eSpark-Backup/manar-harake-s-e-m-g-device/Deliverables/ArmBand-Electrode-Board/_Renderings/3D_Bottom_View.PNG

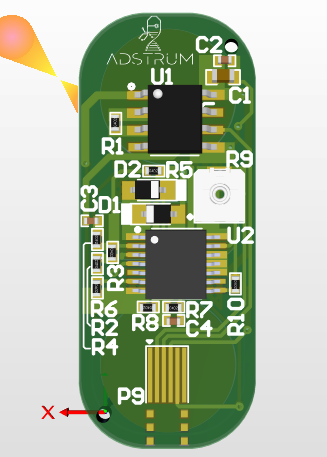
Deliverables/ArmBand-Electrode-Board/_Renderings/3D_Bottom_View.PNG
