eSpark-Backup/manar-harake-s-e-m-g-device/Documents/Client Shared/data acquisition- Flow diagram.pdf

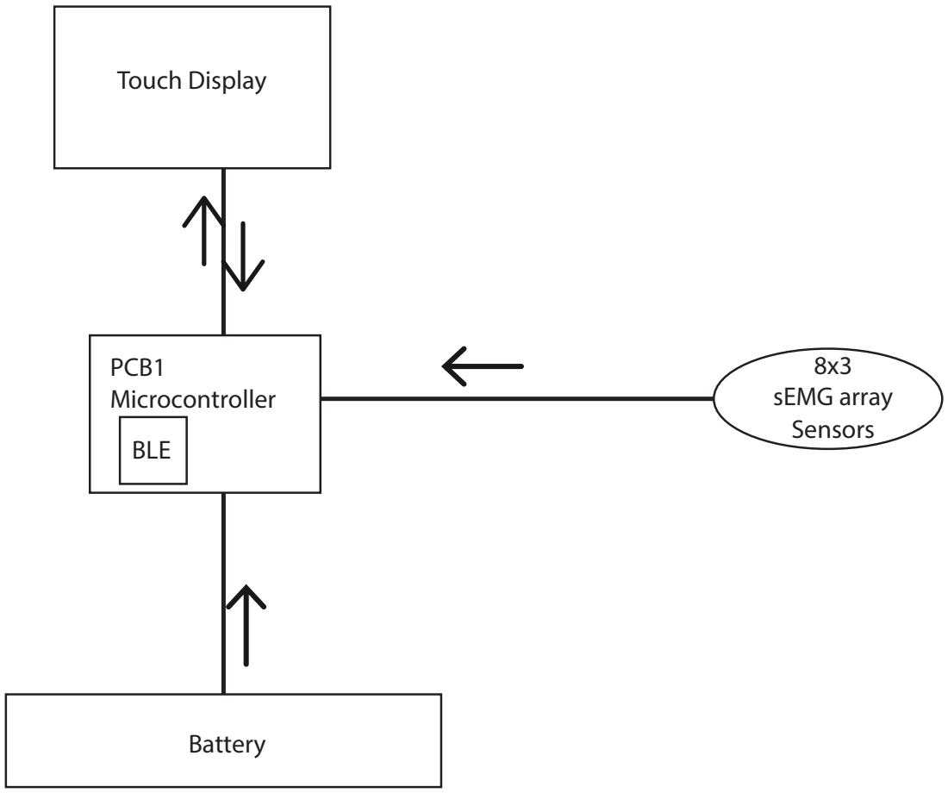
[picture p3: figure]
Touch Display; PCB1 Microcontroller; BLE; 8x3 sEMG array Sensors; Battery
