eSpark-Backup/manar-harake-s-e-m-g-device/Deliverables/ArmBand-Control-Board/_Renderings/2D_Top_View.PNG

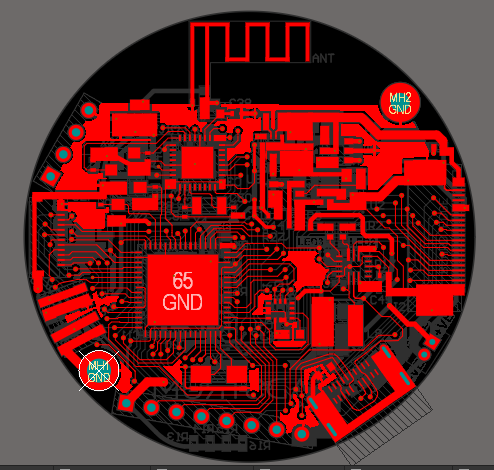
Deliverables/ArmBand-Control-Board/_Renderings/2D_Top_View.PNG
