eSpark-Backup/manar-harake-s-e-m-g-device/Deliverables/ArmBand-Electrode-Board/_Renderings/2D_Top_View.PNG

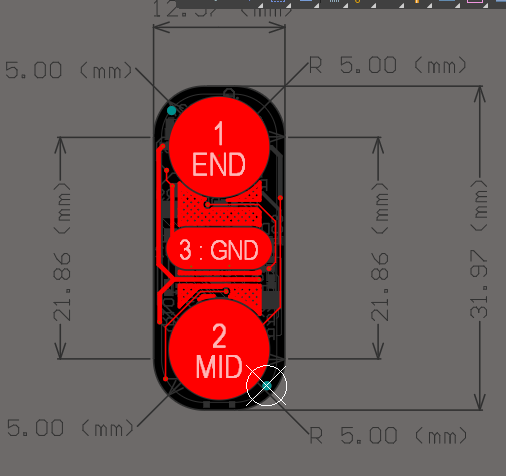
Deliverables/ArmBand-Electrode-Board/_Renderings/2D_Top_View.PNG
