eSpark-Backup/manar-harake-s-e-m-g-device/Deliverables/ArmBand-Electrode-Board/_Renderings/Isometric_View.PNG

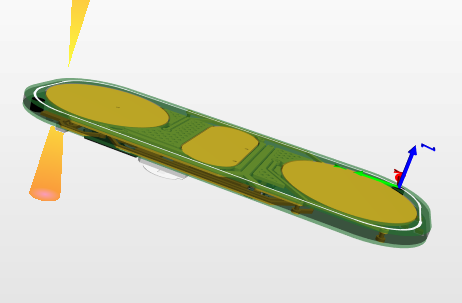
Deliverables/ArmBand-Electrode-Board/_Renderings/Isometric_View.PNG
