eSpark-Backup/manar-harake-s-e-m-g-device/Deliverables/ArmBand-Sensor-Board/_Renderings/2D_Bottom_View.PNG

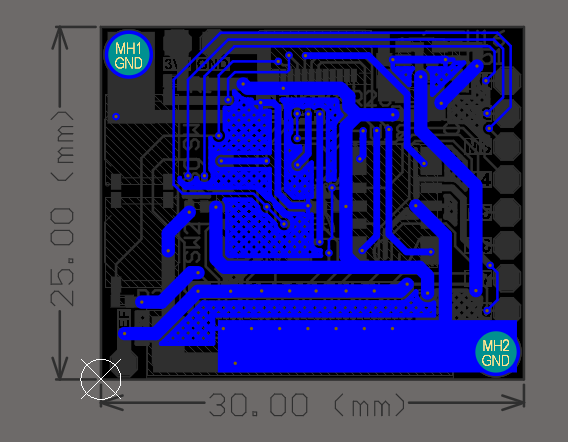
Deliverables/ArmBand-Sensor-Board/_Renderings/2D_Bottom_View.PNG
