eSpark-Backup/manar-harake-s-e-m-g-device/Deliverables/ArmBand-Sensor-Board/_Renderings/2D_C_View.PNG

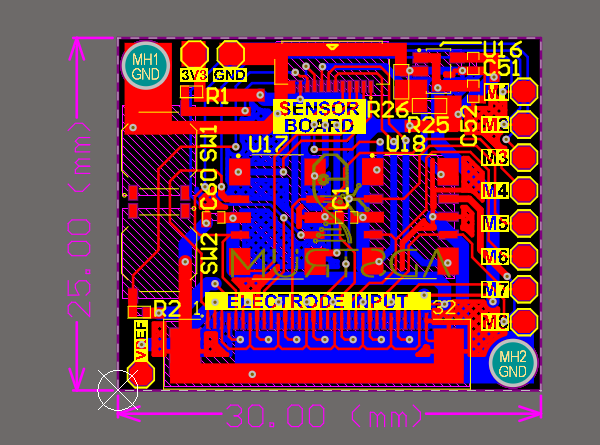
Deliverables/ArmBand-Sensor-Board/_Renderings/2D_C_View.PNG
