eSpark-Backup/manar-harake-s-e-m-g-device/Deliverables/ArmBand-Sensor-Board/_Renderings/3D_Top_View.PNG

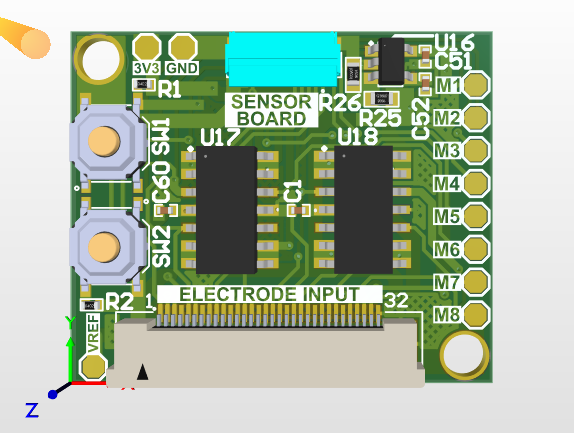
Deliverables/ArmBand-Sensor-Board/_Renderings/3D_Top_View.PNG
