eSpark-Backup/manar-harake-s-e-m-g-device/Deliverables/Control-Board-Flexible-PCB/_Renderings/3D_Top_View.PNG

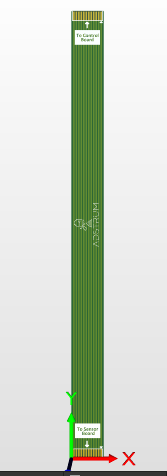
Deliverables/Control-Board-Flexible-PCB/_Renderings/3D_Top_View.PNG
