eSpark-Backup/manar-harake-s-e-m-g-device/Deliverables/Control-Board-Flexible-PCB/_Renderings/Isometric_View.PNG

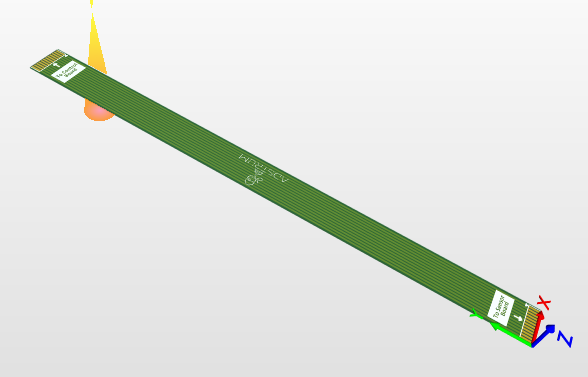
Deliverables/Control-Board-Flexible-PCB/_Renderings/Isometric_View.PNG
