eSpark-Backup/manar-harake-s-e-m-g-device/Deliverables/BOM/Control-Board/Client_BOM-Control-Board.xlsx

 | Component list |  | Bill of Materials for Project [ArmBand-Control-Board.PrjPcb] (No PCB Document Selected)
 | Source Data From: |  | ArmBand-Control-Board.PrjPcb
 | Project: |  | ArmBand-Control-Board.PrjPcb
 | Variant: |  | None
# | Designator | Description | Footprint | Manufacturer Part Number | Manufacturer | Comment | Quantity (1 Board) | Quantity 5 Boards | Remarks
1 | C1, C2, C7 | 0805 22 uF 25 V ±20% Tolerance X5R SMT Multilayer Ceramic Capacitor, CAP CER 22UF 25V X5R 0805 | Cap0805 | GRM21BR61E226ME44L | Murata | 22uF | 3 | 15
2 | C3, C4, C6, C10, C11, C12, C13, C14, C15, C18, C19, C20, C21, C22, C23, C24, C31, C34, C35, C36, C41, C42, C47, C49 | CAP CER 0.1UF 50V X7R 0402 | Cap 0402 | GRM155R71H104ME14D | Murata | 0.1uF | 24 | 120
3 | C5 | CAP CER 10UF 25V X5R 0603 | Cap0603 | CL10A106MA8NRNC | Samsung | 10uF | 1 | 5
4 | C8, C25, C26, C27, C28, C39, C40, C50 | CAP CER 20PF 50V C0G/NPO 0402 | Cap 0402 | CC0402JRNPO9BN200 | Yageo | 20pF | 8 | 40
5 | C9, C33 | 16V 4.7uF ±20% 0402 Multilayer Ceramic Capacitors MLCC | Cap 0402 | EDK105BBJ475MVLF | Taiyo Yuden | 4.7uF | 2 | 10
6 | C16, C32, C43, C45, C46, C48, C51 | CAP CER 1UF 16V X5R 0402 | Cap 0402 | CC0402KRX5R7BB105 | Yageo | 1uF | 7 | 35
7 | C17 | CAP CER 2.2UF 25V X5R 0402 | Cap 0402 | GRM155R61E225KE11D | Murata | 2.2uF | 1 | 5
8 | C37 | CAP CER 100pF 50V C0G 0402 | Cap 0403 | GCM1555C1H101JA16D | Murata | 100pF | 1 | 5
9 | C44 | CAP CER 1000PF 25V X7R 0402 | Cap 0402 | CC0402KRX7R8BB102 | Yageo | 1nF | 1 | 5
10 | C38 | CAP CER 0.8PF 50V C0G/NP0 0402 | Cap 0402 | GJM1555C1HR80WB01D | Murata | 0.8pF | 1 | 5
11 | J1 | CONN U.FL RCPT STR 50 OHM SMD | Custom | U.FL-R-SMT-1(80) | Hirose | --------- | 1 | 5
12 | J4 | CONN RCP USB3.1 TYPEC 24P SMD RA | Custom | 2305018-2 | TE Connectivity AMP | --------- | 1 | 5
13 | J3 | CONN HEADER VERT 2POS 1.5MM | Custom | B2B-ZR(LF)(SN) | JST | --------- | 1 | 5
14 | J2 | Clamshell 22 Double-sided contacts/up and down connection Surface Mount 0.5mm SMD,P=0.5mm FFC/FPC Connectors ROHS | Custom | F0504-H-22-20T-R | XFCN | --------- | 1 | 5
15 | J5 | CONN HEADER VERT 8POS 2.54MM | SMD Header 1x8 | 61300811121 | Wurth Electronics | --------- | 1 | 5
16 | J6 | CONN FPC/FFC 12POS .5MM | Custom | FH34SRJ-12S-0.5SH(50) | Hirose | --------- | 1 | 5
17 | J7 | CONN HEADER VERT 4POS 2.54MM | HDR1X4 SMD | 61300411121 | Wurth Electronics | --------- | 1 | 5
18 | L1 | FIXED IND 2.2UH 1.5A 160MOHM SMD | Custom | MAKK2016T2R2M | Taiyo Yuden | 2.2uH | 1 | 5
19 | L3 | 500mA 10uH ±20% 320mΩ 0805 Inductors (SMD) ROHS | Ind0805 | MGFL2012F100MT-LF | microgate | 10uH | 1 | 5
20 | L4 | 550mA 15nH ±5% 150mΩ SMD,1.68x1x0.85mm Inductors (SMD) ROHS | Custom | SCW1608C15NJST | Sunltech | 15nH | 1 | 5
21 | L5 | Inductor RF Chip Wirewound 3.9nH 0.2nH 100MHz 38Q-Factor 1A 32mOhm DCR 0603 Paper T/R | IND 0603 | LQW18AN3N9C10D | Murata | 3.9nH | 1 | 5
22 | L6 | FERRITE BEAD 30 OHM 0603 1LN / Ferrite Beads Multi-Layer 30Ohm 100MHz 1A 0.05Ohm DCR 0603 T/R | IND 0603 | BLM18PG300SN1D | Murata | ---------- | 1 | 5
23 | L8 | 2.7A 6.8uH ±20% 50mΩ SMD Power Inductors ROHS | Custom | LVC505040-6R8M-N | Chlisin Elec | 6.8uH | 1 | 5
24 | LED1, LED3 | LED GREEN CLEAR CHIP SMD | LED 0402 | XZVG68W-2 | SunLED | ---------- | 2 | 10
25 | LED2 | LED RED CLEAR CHIP SMD | LED 0402 | XZMDK68W-2 | SunLED | ---------- | 1 | 5
26 | R1 | RES SMD 25m Ohms 125mW 0805 | Res0805 | 0805W8F250MT5E | UNI-ROYAL | 0.25R | 1 | 5
27 | R2, R3, R9, R28 | RES 1K OHM 5% 1/16W 0402 | Res0402 | RC0402JR-071KL | Yageo | 1K | 4 | 20
28 | R4, R5, R6, R12, R18, R19, R22, R23, R25, R27 | RES SMD 10K OHM 1% 1/16W 0402 | Res0402 | RC0402FR-0710KL | Yageo | 10K | 10 | 50
29 | R7, R8, R13, R14, R15, R16, R17, R26 | RES SMD 100K OHM 1% 1/5W 0402 | Res0402 | ERJ-PA2F1003X | Panasonic | 100K | 8 | 40
30 | R10, R11 | RES SMD 4.7K OHM 5% 1/10W 0402 | Res0402 | ERJ-2GEJ472X | Panasonic | 4.7K | 2 | 10
31 | R20, R21 | RES 5.1K OHM 1% 1/10W 0603 | Res0603 | RMCF0603FT5K10 | Stackpole Electronics | 5.1K | 2 | 10
32 | R24 | RES SMD 0402 10.7kOhm 0.5% Paper T/R | Res0402 | AC0402DR-0710K7L | Yageo | 10.7K | 1 | 5
33 | ~~SB1, SB2, SB3~~ | ~~Solder Bridge ON~~ | ~~Solder Bridge~~ | ~~----------~~ | ~~----------~~ | ~~----------~~ | ~~3~~ | ~~15~~ | ~~DO NOT MOUNT~~
34 | SW1, SW2 | 3mm 2mm Round Button 50mA Top3.65mm SPST 12V SMD Tactile Switches | Custom | TS-1185EC-C-D-B | XKB | ---------- | 2 | 10
35 | U1 | 2.1A, 1- OR 2-CELL LI-ION BATTER | QFN(3X3) | MP2615CGQ-Z | Monolithic Power Systems | ---------- | 1 | 5
36 | U2 | IC MPU/RESET CIRC SOT23-3 | SOT-23 | MAX809SEUR+T | Maxim | ---------- | 1 | 5
37 | U3 | IC PWR SWITCH P-CH 1:1 SUPERSOT6 | SuperSOT™-6 | FDC6330L | ON Semiconductor / Fairchild | ---------- | 1 | 5
38 | U4 | Buck Switching Regulator IC Positive Fixed 3.3V 1 Output 1A 8-WFDFN Exposed Pad | 8-WSON (2x2) | TPS62162DSGR | Texas Instruments | ---------- | 1 | 5
39 | U5 | IC MCU 32BIT 512KB FLASH 64QFN | QFN64 | ATSAM4S8BA-MU | Microchip | ---------- | 1 | 5
40 | U6 | IC RF TXRX+MCU BLUETOOTH 32WFQFN | 32 QFN | NRF52810-QCAA-R | Nordic Semiconductor | ---------- | 1 | 5
41 | U7 | iNEMO Inertial Module: 3D Accelerometer and 3D Gyroscope, 1.71V to 3.6V, -40°C to 85°C, VFLGA-14L, RoHS | 14-LGA (2.5x3) | LSM6DSRTR | STMicroelectronics | ---------- | 1 | 5
42 | U8 | 300mA 75dB@1kHz 10nA 90mV 2.8V~2.8V 2 6V SOT-23-6 Linear Voltage Regulators (LDO) ROHS | SOT-23-6 | VRD2828PTX | AnaSem | ---------- | 1 | 5
43 | X1, X4 | 32.768kHz SMD Crystal Resonator 12.5pF ±20ppm -40℃~+85℃ SMD3215-2P Crystals ROHS | Custom | X321532768KGD2SI | Yangxing Tech | 32.768kHz | 2 | 10
44 | X2 | 16MHz SMD Crystal Resonator 12pF ±10ppm ±30ppm -40℃~+85℃ SMD3225-4P Crystals ROHS | Custom | X322516MOB4SI | Yangxing Tech | 16MHz | 1 | 5
45 | X3 | 32MHz SMD Crystal Resonator 12pF 40Ω ±10ppm ±20ppm -40℃~+85℃ SMD3225-4P Crystals ROHS | Custom | XC32M4-32.000-F12NLDT | HCI | 32MHz | 1 | 5
 | Approved
 | Notes
