eSpark-Backup/manar-harake-s-e-m-g-device/Deliverables/BOM/Control-Board/eSpark_BOM-Control-Board.xlsx

 | Component list |  | Bill of Materials for Project [ArmBand-Control-Board.PrjPcb] (No PCB Document Selected)
 | Source Data From: |  | ArmBand-Control-Board.PrjPcb
 | Project: |  | ArmBand-Control-Board.PrjPcb
 | Variant: |  | None
# | Designator | Description | Footprint | Manufacturer Part Number | Alternate Part No | Manufacturer | LCSC/Part No | Comment | Quantity (1 Board) | Quantity (5 Boards) | LCSC/MOQ/5 Boards | Links | Unit Cost/5 Boards | Total Cost/5 Boards | Remarks (Iftikhar) | Remarks (Faizan)
1 | C1, C2, C7 | 0805 22 uF 25 V ±20% Tolerance X5R SMT Multilayer Ceramic Capacitor, CAP CER 22UF 25V X5R 0805 | Cap0805 | GRM21BR61E226ME44L | --------- | Murata | C86816 | 22uF | 3 | 15 | 20 | LCSC (https://lcsc.com/product-detail/Multilayer-Ceramic-Capacitors-MLCC-SMD-SMT_Murata-Electronics-GRM21BR61E226ME44L_C86816.html) | $0.0694 | $1.3880
2 | C3, C4, C6, C10, C11, C12, C13, C14, C15, C18, C19, C20, C21, C22, C23, C24, C31, C34, C35, C36, C41, C42, C47, C49 | CAP CER 0.1UF 50V X7R 0402 | Cap 0402 | ~~GRM155R71H104ME14D~~ | CL05B104KB54PNC | Murata | C307331 | 0.1uF | 24 | 120 | 150 | LCSC (https://lcsc.com/product-detail/Multilayer-Ceramic-Capacitors-MLCC-SMD-SMT_Samsung-Electro-Mechanics-CL05B104KB54PNC_C307331.html) | $0.0072 | $1.0800
3 | C5 | CAP CER 10UF 25V X5R 0603 | Cap0603 | ~~CL10A106MA8NRNC~~ | GRM188R61E106MA73D | Samsung | C91606 | 10uF | 1 | 5 | 10 | LCSC (https://lcsc.com/product-detail/Multilayer-Ceramic-Capacitors-MLCC-SMD-SMT_Murata-Electronics-GRM188R61E106MA73D_C91606.html) | $0.0328 | $0.3280 |  | Part changed, orignal discontinued
4 | C8, C25, C26, C27, C28, C39, C40, C50 | CAP CER 20PF 50V C0G/NPO 0402 | Cap 0402 | CC0402JRNPO9BN200 | --------- | Yageo | C107000 | 20pF | 8 | 40 | 100 | LCSC (https://lcsc.com/product-detail/Multilayer-Ceramic-Capacitors-MLCC-SMD-SMT_YAGEO-CC0402JRNPO9BN200_C107000.html) | $0.0014 | $0.1400
5 | C9, C33 | 16V 4.7uF ±20% 0402 Multilayer Ceramic Capacitors MLCC | Cap 0402 | EDK105BBJ475MVLF | --------- | Taiyo Yuden | C412302 | 4.7uF | 2 | 10 | 50 | LCSC (https://lcsc.com/product-detail/Multilayer-Ceramic-Capacitors-MLCC-SMD-SMT_Taiyo-Yuden-EDK105BBJ475MVLF_C412302.html) | $0.0185 | $0.9250
6 | C16, C32, C43, C45, C46, C48, C51 | CAP CER 1UF 16V X5R 0402 | Cap 0402 | CC0402KRX5R7BB105 | --------- | Yageo | C325464 | 1uF | 7 | 35 | 50 | LCSC (https://lcsc.com/product-detail/Multilayer-Ceramic-Capacitors-MLCC-SMD-SMT_YAGEO-CC0402KRX5R7BB105_C325464.html) | $0.0065 | $0.3250
7 | C17 | CAP CER 2.2UF 25V X5R 0402 | Cap 0402 | GRM155R61E225KE11D | --------- | Murata | C385032 | 2.2uF | 1 | 5 | 10 | LCSC (https://lcsc.com/product-detail/Multilayer-Ceramic-Capacitors-MLCC-SMD-SMT_Murata-Electronics-GRM155R61E225KE11D_C385032.html) | $0.0489 | $0.4890
8 | C37 | CAP CER 100pF 50V C0G 0402 | Cap 0403 | GCM1555C1H101JA16D | --------- | 100pF | C126492 | 100pF | 1 | 5 | 50 | LCSC (https://lcsc.com/product-detail/Multilayer-Ceramic-Capacitors-MLCC-SMD-SMT_Murata-Electronics-GCM1555C1H101JA16D_C126492.html) | $0.0095 | $0.4800
9 | C44 | CAP CER 1000PF 25V X7R 0402 | Cap 0402 | CC0402KRX7R8BB102 | --------- | Yageo | C541372 | 1nF | 1 | 5 | 100 | LCSC (https://lcsc.com/product-detail/Multilayer-Ceramic-Capacitors-MLCC-SMD-SMT_YAGEO-CC0402KRX7R8BB102_C541372.html) | $0.0016 | $0.1600
10 | C38 | CAP CER 0.8PF 50V C0G/NP0 0402 | Cap 0402 | GJM1555C1HR80WB01D | --------- | Murata | C88902 | 0.8pF | 1 | 5 | 20 | LCSC (https://lcsc.com/product-detail/Multilayer-Ceramic-Capacitors-MLCC-SMD-SMT_Murata-Electronics-GJM1555C1HR80WB01D_C88902.html) | $0.0303 | $0.6060
11 | J1 | CONN U.FL RCPT STR 50 OHM SMD | Custom | U.FL-R-SMT-1(80) | --------- | Hirose | C88374 | --------- | 1 | 5 | 10 | LCSC (https://lcsc.com/product-detail/RF-Connectors-Coaxial-Connectors_HRS-Hirose-U-FL-R-SMT-1-80_C88374.html) | $0.0932 | $0.9320
12 | J4 | CONN RCP USB3.1 TYPEC 24P SMD RA | Custom | 2305018-2 | --------- | TE Connectivity AMP | C498674 | --------- | 1 | 5 | 6 | LCSC (https://lcsc.com/product-detail/USB-Connectors_TE-Connectivity-2305018-2_C498674.html) | $2.3786 | $14.2716
13 | ~~J3~~ | ~~CONN HEADER VERT 2POS 1.5MM~~ | ~~Custom~~ | ~~B2B-ZR(LF)(SN)~~ | ~~---------~~ | ~~JST~~ | ~~C158011~~ | ~~---------~~ | ~~1~~ | ~~5~~ | ~~20~~ | ~~LCSC~~ (https://lcsc.com/product-detail/Wire-To-Board-Wire-To-Wire-Connector_JST-Sales-America-B2B-ZR-LF-SN_C158011.html) |  | ~~$0.0000~~ |  | ~~DO NOT MOUNT~~
14 | J2 | Clamshell 22 Double-sided contacts/up and down connection Surface Mount 0.5mm SMD,P=0.5mm FFC/FPC Connectors ROHS | Custom | F0504-H-22-20T-R | --------- | XFCN | C557729 | --------- | 1 | 5 | 6 | LCSC (https://lcsc.com/product-detail/FFC-FPC-Connectors_XFCN-F0504-H-22-20T-R_C557729.html) | $0.1866 | $1.1196
15 | J5 | CONN HEADER VERT 8POS 2.54MM | SMD Header 1x8 | 61300811121 | --------- | Wurth Electronics | C2935914 | --------- | 1 | 5 | 10 | LCSC (https://lcsc.com/product-detail/span-style-background-color-ff0-Pin-span-Headers_DEALON-DZ254R-11-08-63_C2935914.html) | $0.0431 | $0.4310
16 | J6 | CONN FPC/FFC 12POS .5MM | Custom | FH34SRJ-12S-0.5SH(50) | ------ | Hirose | C424659 | --------- | 1 | 5 | 6 | LCSC (https://lcsc.com/product-detail/FFC-FPC-Connectors_HRS-Hirose-FH34SRJ-12S-0-5SH-50_C424659.html) | $0.1832 | $1.0992
17 | J7 | CONN HEADER VERT 4POS 2.54MM | HDR1X4 SMD | 61300411121 | ------- | Wurth Electronics | C2935910 | --------- | 1 | 5 | 20 | LCSC (https://lcsc.com/product-detail/span-style-background-color-ff0-Pin-span-Headers_DEALON-DZ254R-11-04-63_C2935910.html) | $0.0229 | $0.4580
18 | L1 | FIXED IND 2.2UH 1.5A 160MOHM SMD | Custom | MAKK2016T2R2M | ------- | Taiyo Yuden | ------- | 2.2uH | 1 | 5 | 6 | ---------- | $0.4800 | $2.88 | Need Fresh Quote From Custom Supplier | Quote added from Lulu
19 | L3 | 500mA 10uH ±20% 320mΩ 0805 Inductors (SMD) ROHS | Ind0805 | MGFL2012F100MT-LF | --------- | microgate | C281113 | 10uH | 1 | 5 | 10 | LCSC (https://lcsc.com/product-detail/Inductors-SMD_microgate-MGFL2012F100MT-LF_C281113.html) | $0.0446 | $0.4460
20 | L4 | 550mA 15nH ±5% 150mΩ SMD,1.68x1x0.85mm Inductors (SMD) ROHS | Custom | SCW1608C15NJST | --------- | Sunltech | C231879 | 15nH | 1 | 5 | 10 | LCSC (https://lcsc.com/product-detail/Inductors-SMD_Sunltech-Tech-SCW1608C15NJST_C231879.html) | $0.0573 | $0.5730
21 | L5 | Inductor RF Chip Wirewound 3.9nH 0.2nH 100MHz 38Q-Factor 1A 32mOhm DCR 0603 Paper T/R | IND 0603 | LQW18AN3N9C10D | --------- | Murata | C521237 | 3.9nH | 1 | 5 | 10 | LCSC (https://lcsc.com/product-detail/Inductors-SMD_Murata-Electronics-LQW18AN3N9C10D_C521237.html) | $0.0646 | $0.6460
22 | L6 | FERRITE BEAD 30 OHM 0603 1LN / Ferrite Beads Multi-Layer 30Ohm 100MHz 1A 0.05Ohm DCR 0603 T/R | IND 0603 | BLM18PG300SN1D | --------- | Murata | C17305 | ---------- | 1 | 5 | 50 | LCSC (https://lcsc.com/product-detail/Ferrite-Beads_Murata-Electronics-BLM18PG300SN1D_C17305.html) | $0.0086 | $0.4300
23 | L8 | 2.7A 6.8uH ±20% 50mΩ SMD Power Inductors ROHS | Custom | LVC505040-6R8M-N |  | Chlisin Elec | C285870 | 6.8uH | 1 | 5 | 10 | LCSC (https://www.lcsc.com/product-detail/Power-Inductors_Chilisin-Elec-LVC505040-6R8M-N_C285870.html) | $0.0943 | $0.9430
24 | LED1, LED3 | LED GREEN CLEAR CHIP SMD | LED 0402 | ~~XZVG68W-2~~ | SZYY0402YG | SunLED | C434449 | ---------- | 2 | 10 | 50 | LCSC (https://lcsc.com/product-detail/Light-Emitting-Diodes-span-style-background-color-ff0-LED-span_Yongyu-Photoelectric-SZYY0402YG_C434449.html) | $0.0175 | $0.8750
25 | LED2 | LED RED CLEAR CHIP SMD | LED 0402 | ~~XZMDK68W-2~~ | 16-213/SDRC/S530-A3/TR8 | SunLED | C71911 | ---------- | 1 | 5 | 10 | LCSC (https://lcsc.com/product-detail/Light-Emitting-Diodes-span-style-background-color-ff0-LED-span_Everlight-Elec-16-213-SDRC-S530-A3-TR8_C71911.html) | $0.0524 | $0.5240
26 | R1 | RES SMD 25m Ohms 125mW 0805 | Res0805 | 0805W8F250MT5E | --------- | UNI-ROYAL | C620515 | 0.25R | 1 | 5 | 50 | LCSC (https://lcsc.com/product-detail/Chip-Resistor-Surface-Mount_UNI-ROYAL-Uniroyal-Elec-0805W8F250MT5E_C620515.html) | $0.0105 | $0.5250
27 | R2, R3, R9, R28 | RES 1K OHM 5% 1/16W 0402 | Res0402 | RC0402JR-071KL | --------- | Yageo | C105637 | 1K | 4 | 20 | 100 | LCSC (https://lcsc.com/product-detail/Chip-Resistor-Surface-Mount_YAGEO-RC0402JR-071KL_C105637.html) | $0.0006 | $0.0600
28 | R4, R5, R6, R12, R18, R19, R22, R23, R25, R27 | RES SMD 10K OHM 1% 1/16W 0402 | Res0402 | RC0402FR-0710KL | --------- | Yageo | C60490 | 10K | 10 | 50 | 100 | LCSC (https://lcsc.com/product-detail/Chip-Resistor-Surface-Mount_YAGEO-RC0402FR-0710KL_C60490.html) | $0.0006 | $0.0600
29 | R7, R8, R13, R14, R15, R16, R17, R26 | RES SMD 100K OHM 1% 1/5W 0402 | Res0402 | ~~ERJ-PA2F1003X~~ | 0402WGF1003TCE | Panasonic | C25741 | 100K | 8 | 40 | 100 | LCSC (https://lcsc.com/product-detail/Chip-span-style-background-color-ff0-Resistor-span-Surface-Mount_UNI-ROYAL-Uniroyal-Elec-0402WGF1003TCE_C25741.html) | $0.0006 | $0.0600
30 | R10, R11 | RES SMD 4.7K OHM 5% 1/10W 0402 | Res0402 | ~~ERJ-2GEJ472X~~ | AC0402JR-074K7L | Panasonic | C144709 | 4.7K | 2 | 10 | 100 | LCSC (https://lcsc.com/product-detail/Chip-span-style-background-color-ff0-Resistor-span-Surface-Mount_YAGEO-AC0402JR-074K7L_C144709.html) | $0.0008 | $0.0800
31 | R20, R21 | RES 5.1K OHM 1% 1/10W 0603 | Res0603 | ~~RMCF0603FT5K10~~ | RMC06035.1K1%N | Stackpole Electronics | C269716 | 5.1K | 2 | 10 | 100 | LCSC (https://lcsc.com/product-detail/Chip-span-style-background-color-ff0-Resistor-span-Surface-Mount_TyoHM-RMC06035-1K1-N_C269716.html) | $0.0036 | $0.3600
32 | R24 | RES SMD 0402 10.7kOhm 0.5% Paper T/R | Res0402 | AC0402DR-0710K7L | --------- | Yageo | C226678 | 10.7K | 1 | 5 | 50 | LCSC (https://lcsc.com/product-detail/Chip-Resistor-Surface-Mount_YAGEO-AC0402DR-0710K7L_C226678.html) | $0.0007 | $0.0350
33 | ~~SB1, SB2, SB3~~ | ~~Solder Bridge ON~~ | ~~Solder Bridge~~ | ~~----------~~ |  | ~~----------~~ | ~~--------~~ | ~~----------~~ | ~~3~~ | ~~15~~ | ~~---------~~ | ~~----------~~ | ~~---------~~ | ~~----------~~ | ~~DO NOT MOUNT~~
34 | SW1, SW2 | 3mm 2mm Round Button 50mA Top3.65mm SPST 12V SMD Tactile Switches | Custom | TS-1185EC-C-D-B | --------- | XKB | C318893 | ---------- | 2 | 10 | 10 | LCSC (https://lcsc.com/product-detail/Tactile-Switches_XKB-Connectivity-TS-1185EC-C-D-B_C318893.html) | $0.0606 | $0.6060
35 | U1 | 2.1A, 1- OR 2-CELL LI-ION BATTER | QFN(3X3) | MP2615CGQ-Z | -------- | Monolithic Power Systems | -------- | ---------- | 1 | 5 | 6 | ---------- | $3.9400 | $23.64 | Need Fresh Quote From Custom Supplier | Quote added from Lulu
36 | U2 | IC MPU/RESET CIRC SOT23-3 | SOT-23 | MAX809SEUR+T | --------- | Maxim | C7270 | ---------- | 1 | 5 | 6 | LCSC (https://lcsc.com/product-detail/Monitors-Reset-Circuits_Maxim-Integrated-MAX809SEUR-T_C7270.html) | $0.4941 | $2.9646
37 | U3 | IC PWR SWITCH P-CH 1:1 SUPERSOT6 | SuperSOT™-6 | FDC6330L | --------- | ON Semiconductor / Fairchild | -------- | ---------- | 1 | 5 | 6 | ---------- | $1.5750 | $9.4500 |  | Quote added from Lulu
38 | U4 | Buck Switching Regulator IC Positive Fixed 3.3V 1 Output 1A 8-WFDFN Exposed Pad | 8-WSON (2x2) | TPS62162DSGR | --------- | Texas Instruments | C40256 | ---------- | 1 | 5 | 6 | ---------- (https://lcsc.com/product-detail/DC-DC-Converters_Texas-Instruments-TPS62162DSGR_C40256.html) | $7.8800 | $47.2800 | Is part ki Price high ha @urooj custom supplier se Quote le len | Quote changed after receiving better rates from Lulu
39 | U5 | IC MCU 32BIT 512KB FLASH 64QFN | QFN64 | ATSAM4S8BA-MU | --------- | Microchip | --------- | ---------- | 1 | 5 | 6 | ---------- | $12.6000 | $75.6000 | Need Fresh Quote From Custom Supplier | Quote added from Lulu
40 | U6 | IC RF TXRX+MCU BLUETOOTH 32WFQFN | 32 QFN | NRF52810-QCAA-R | --------- | Nordic Semiconductor | C519278 | ---------- | 1 | 5 | 6 | LCSC (https://lcsc.com/product-detail/RF-Transceiver-ICs_Nordic-Semicon-nRF52810-QCAA-R_C519278.html) | $2.8510 | $17.1060
41 | U7 | iNEMO Inertial Module: 3D Accelerometer and 3D Gyroscope, 1.71V to 3.6V, -40°C to 85°C, VFLGA-14L, RoHS | 14-LGA (2.5x3) | LSM6DSRTR | --------- | STMicroelectronics | C784817 | ---------- | 1 | 5 | 6 | LCSC (https://lcsc.com/product-detail/Motion-Sensors-Accelerometers_STMicroelectronics-LSM6DSRTR_C784817.html) | $4.3279 | $25.9674
42 | U8 | 300mA 75dB@1kHz 10nA 90mV 2.8V~2.8V 2 6V SOT-23-6 Linear Voltage Regulators (LDO) ROHS | SOT-23-6 | VRD2828PTX | --------- | AnaSem | C697937 | ---------- | 1 | 5 | 10 | LCSC (https://lcsc.com/product-detail/Linear-Voltage-Regulators-LDO_AnaSem-VRD2828PTX_C697937.html) | $0.0204 | $0.2040
43 | X1, X4 | 32.768kHz SMD Crystal Resonator 12.5pF ±20ppm -40℃~+85℃ SMD3215-2P Crystals ROHS | Custom | X321532768KGD2SI | --------- | Yangxing Tech | C620155 | 32.768kHz | 2 | 10 | 11 | LCSC (https://lcsc.com/product-detail/Crystals_Yangxing-Tech-X321532768KGD2SI_C620155.html) | $0.3364 | $3.7004
44 | X2 | 16MHz SMD Crystal Resonator 12pF ±10ppm ±30ppm -40℃~+85℃ SMD3225-4P Crystals ROHS | Custom | X322516MOB4SI | --------- | Yangxing Tech | C12668 | 16MHz | 1 | 5 | 10 | LCSC (https://lcsc.com/product-detail/Crystals_Yangxing-Tech-X322516MOB4SI_C12668.html) | $0.0971 | $0.9710
45 | X3 | 32MHz SMD Crystal Resonator 12pF 40Ω ±10ppm ±20ppm -40℃~+85℃ SMD3225-4P Crystals ROHS | Custom | XC32M4-32.000-F12NLDT | --------- | HCI | C2905357 | 32MHz | 1 | 5 | 10 | LCSC (https://lcsc.com/product-detail/Crystals_HCI-XC32M4-32-000-F12NLDT_C2905357.html) | $0.1344 | $1.3440
 | Approved |  |  |  |  |  |  |  |  |  | Total Component Cost |  |  | $241.56
 | Notes |  |  |  |  |  |  |  |  |  | Single Board Cost |  |  | $48.31
