eSpark-Backup/manar-harake-s-e-m-g-device/Deliverables/BOM/Control-Board/PCBWay_BOM-Control-Board.xlsx

Sheet: Sheet1
 | Component list |  | Bill of Materials for Project [ArmBand-Control-Board.PrjPcb] (No PCB Document Selected)
 | Source Data From: |  | ArmBand-Control-Board.PrjPcb
 | Project: |  | ArmBand-Control-Board.PrjPcb
 | Variant: |  | None
# | Designator | Description | Footprint | Manufacturer Part Number | Manufacturer | LCSC/Part No | Comment | Quantity (Per Board) | LCSC/MOQ/5 Boards
1 | C1, C2, C7 | 0805 22 uF 25 V ±20% Tolerance X5R SMT Multilayer Ceramic Capacitor, CAP CER 22UF 25V X5R 0805 | Cap0805 | GRM21BR61E226ME44L | Murata | C86816 | 22uF | 3 | 20
2 | C3, C4, C6, C10, C11, C12, C13, C14, C15, C18, C19, C20, C21, C22, C24, C31, C34, C35, C36, C37, C41, C42, C47, C49 | CAP CER 0.1UF 50V X7R 0402 | Cap 0402 | CL05B104KB54PNC | Murata | C307331 | 0.1uF | 24 | 150
3 | C5 | CAP CER 10UF 25V X5R 0603 | Cap0603 | CL10A106MA8NRNC | Samsung | C2922482 | 10uF | 1 | 20
4 | C8, C25, C26, C27, C28, C39, C40, C50 | CAP CER 20PF 50V C0G/NPO 0402 | Cap 0402 | CC0402JRNPO9BN200 | Yageo | C107000 | 20pF | 8 | 100
5 | C9, 33 | 16V 4.7uF ±20% 0402 Multilayer Ceramic Capacitors MLCC | Cap 0402 | EDK105BBJ475MVLF | Taiyo Yuden | C412302 | 4.7uF | 2 | 50
6 | C16, C30, C32, C43, C45, C46, C48, C51 | CAP CER 1UF 16V X5R 0402 | Cap 0402 | CC0402KRX5R7BB105 | Yageo | C325464 | 1uF | 8 | 50
7 | C17 | CAP CER 2.2UF 25V X5R 0402 | Cap 0402 | GRM155R61E225KE11D | Murata | C385032 | 2.2uF | 1 | 10
8 | C44 | CAP CER 1000PF 25V X7R 0402 | Cap 0402 | CC0402KRX7R8BB102 | Yageo | C541372 | 1nF | 1 | 100
9 | C38 | CAP CER 0.8PF 50V C0G/NP0 0402 | Cap 0402 | GJM1555C1HR80WB01D | Murata | C88902 | 0.8pF | 1 | 20
10 | J1 | CONN U.FL RCPT STR 50 OHM SMD | Custom | U.FL-R-SMT-1(80) | Hirose | C88374 | --------- | 1 | 10
11 | J4 | CONN RCP USB3.1 TYPEC 24P SMD RA | Custom | 2305018-2 | TE Connectivity AMP | C498674 | --------- | 1 | 6
12 | J3 | CONN HEADER VERT 2POS 1.5MM | Custom | B2B-ZR(LF)(SN) | JST | C158011 | --------- | 1 | 20
13 | J2 | Clamshell 22 Double-sided contacts/up and down connection Surface Mount 0.5mm SMD,P=0.5mm FFC/FPC Connectors ROHS | Custom | F0504-H-22-20T-R | XFCN | C557729 | --------- | 1 | 6
14 | J5 | CONN HEADER VERT 8POS 2.54MM | SMD Header 1x8 | 61300811121 | Wurth Electronics | C2935914 | --------- | 1 | 10
15 | J6 | CONN FPC/FFC 12POS .5MM | Custom | FH34SRJ-12S-0.5SH(50) | Hirose | C424659 | --------- | 1 | 6
16 | J7 | CONN HEADER VERT 4POS 2.54MM | HDR1X4 SMD | 61300411121 | Wurth Electronics | C2935910 | --------- | 1 | 20
17 | L1 | FIXED IND 2.2UH 1.5A 160MOHM SMD | Custom | MAKK2016T2R2M | Taiyo Yuden | ------- | 2.2uH | 1 | 7
18 | L3 | 500mA 10uH ±20% 320mΩ 0805 Inductors (SMD) ROHS | Ind0805 | MGFL2012F100MT-LF | microgate | C281113 | 10uH | 1 | 10
19 | L4 | 550mA 15nH ±5% 150mΩ SMD,1.68x1x0.85mm Inductors (SMD) ROHS | Custom | SCW1608C15NJST | Sunltech | C231879 | 15nH | 1 | 10
20 | L5 | Inductor RF Chip Wirewound 3.9nH 0.2nH 100MHz 38Q-Factor 1A 32mOhm DCR 0603 Paper T/R | IND 0603 | LQW18AN3N9C10D | Murata | C521237 | 3.9nH | 1 | 10
21 | L6 | FERRITE BEAD 30 OHM 0603 1LN / Ferrite Beads Multi-Layer 30Ohm 100MHz 1A 0.05Ohm DCR 0603 T/R | IND 0603 | BLM18PG300SN1D | Murata | C17305 | ---------- | 1 | 50
22 | L8 | 2.7A 6.8uH ±20% 50mΩ SMD Power Inductors ROHS | Custom | LVC505040-6R8M-N | Chlisin Elec | C285870 | 6.8uH | 1 | 10
23 | LED1, LED3 | LED GREEN CLEAR CHIP SMD | LED 0402 | SZYY0402YG | SunLED | C434449 | ---------- | 2 | 50
24 | LED2 | LED RED CLEAR CHIP SMD | LED 0402 | 16-213/SDRC/S530-A3/TR8 | SunLED | C71911 | ---------- | 1 | 10
25 | R1 | RES SMD 25m Ohms 125mW 0805 | Res0805 | 0805W8F250MT5E | UNI-ROYAL | C620515 | 0.25R | 1 | 50
26 | R2, R3, R9, R28 | RES 1K OHM 5% 1/16W 0402 | Res0402 | RC0402JR-071KL | Yageo | C105637 | 1K | 4 | 100
27 | R4, R5, R6, R12, R18, R19, R22, R23, R25, R27 | RES SMD 10K OHM 1% 1/16W 0402 | Res0402 | RC0402FR-0710KL | Yageo | C60490 | 10K | 10 | 100
28 | R7 | 62.5mW Thick Film Resistors 50V ±5% ±200ppm/℃ 1Ω -55℃~+155℃ 0402 Chip Resistor - Surface Mount ROHS | Res0402 | FRC0402J1R0 TS | FOJAN | C2906901 | 1R | 1 | 100
29 | R8, R13, R14, R15, R16, R17, R26 | RES SMD 100K OHM 1% 1/5W 0402 | Res0402 | 0402WGF1003TCE | Panasonic | C25741 | 100K | 7 | 100
30 | R10, R11 | RES SMD 4.7K OHM 5% 1/10W 0402 | Res0402 | AC0402JR-074K7L | Panasonic | C144709 | 4.7K | 2 | 100
31 | R20, R21 | RES 5.1K OHM 1% 1/10W 0603 | Res0603 | RMC06035.1K1%N | Stackpole Electronics | C269716 | 5.1K | 2 | 100
32 | R24 | RES SMD 0402 10.7kOhm 0.5% Paper T/R | Res0402 | AC0402DR-0710K7L | Yageo | C226678 | 10.7K | 1 | 50
33 | SB1, SB2, SB3 | Solder Bridge ON | Solder Bridge | ---------- | ---------- | -------- | ---------- | 3 | ---------
34 | SW1 | 3mm 2mm Round Button 50mA Top3.65mm SPST 12V SMD Tactile Switches | Custom | TS-1185EC-C-D-B | XKB | C318893 | ---------- | 1 | 10
35 | U1 | 2.1A, 1- OR 2-CELL LI-ION BATTER | QFN(3X3) | MP2615CGQ-Z | Monolithic Power Systems | -------- | ---------- | 1 | 6
36 | U2 | IC MPU/RESET CIRC SOT23-3 | SOT-23 | MAX809SEUR+T | Maxim | C7270 | ---------- | 1 | 6
37 | U3 | IC PWR SWITCH P-CH 1:1 SUPERSOT6 | SuperSOT™-6 | FDC6330L | ON Semiconductor / Fairchild | -------- | ---------- | 1 | 6
38 | U4 | Buck Switching Regulator IC Positive Fixed 3.3V 1 Output 1A 8-WFDFN Exposed Pad | 8-WSON (2x2) | TPS62162DSGR | Texas Instruments | C40256 | ---------- | 1 | 6
39 | U5 | IC MCU 32BIT 512KB FLASH 64QFN | QFN64 | ATSAM4S8BA-MU | Microchip | --------- | ---------- | 1 | 6
40 | U6 | IC RF TXRX+MCU BLUETOOTH 32WFQFN | 32 QFN | NRF52810-QCAA-R | Nordic Semiconductor | C519278 | ---------- | 1 | 6
41 | U7 | iNEMO Inertial Module: 3D Accelerometer and 3D Gyroscope, 1.71V to 3.6V, -40°C to 85°C, VFLGA-14L, RoHS | 14-LGA (2.5x3) | LSM6DSRTR | STMicroelectronics | C784817 | ---------- | 1 | 6
42 | U8 | 300mA 75dB@1kHz 10nA 90mV 2.8V~2.8V 2 6V SOT-23-6 Linear Voltage Regulators (LDO) ROHS | SOT-23-6 | VRD2828PTX | AnaSem | C697937 | ---------- | 1 | 10
43 | X1, X4 | 32.768kHz SMD Crystal Resonator 12.5pF ±20ppm -40℃~+85℃ SMD3215-2P Crystals ROHS | Custom | X321532768KGD2SI | Yangxing Tech | C620155 | 32.768kHz | 2 | 11
44 | X2 | 16MHz SMD Crystal Resonator 12pF ±10ppm ±30ppm -40℃~+85℃ SMD3225-4P Crystals ROHS | Custom | X322516MOB4SI | Yangxing Tech | C12668 | 16MHz | 1 | 10
45 | X3 | 32MHz SMD Crystal Resonator 12pF 40Ω ±10ppm ±20ppm -40℃~+85℃ SMD3225-4P Crystals ROHS | Custom | XC32M4-32.000-F12NLDT | HCI | C2905357 | 32MHz | 1 | 10
 | Approved
 | Notes

Sheet: Sheet2
 |  | Component list |  | Bill of Materials for Project [ArmBand-Control-Board.PrjPcb] (No PCB Document Selected)
 |  | Source Data From: |  | ArmBand-Control-Board.PrjPcb
 |  | Project: |  | ArmBand-Control-Board.PrjPcb
 |  | Variant: |  | None
# | Item Type | Designator | Description | Footprint | Manufacturer Part Number | Manufacturer | LCSC/Part No | Comment | Quantity (1 Board) | LCSC/MOQ/5 Boards | Remarks
1 | Capacitor | C1, C2, C7 | 0805 22 uF 25 V ±20% Tolerance X5R SMT Multilayer Ceramic Capacitor, CAP CER 22UF 25V X5R 0805 | Cap0805 | GRM21BR61E226ME44L | Murata | C86816 | 22uF | 3 | 20
2 |  | C3, C4, C6, C10, C11, C12, C13, C14, C15, C18, C19, C20, C21, C22, C23, C24, C31, C34, C35, C36, C41, C42, C47, C49 | CAP CER 0.1UF 50V X7R 0402 | Cap 0402 | CL05B104KB54PNC | Murata | C307331 | 0.1uF | 24 | 150
3 |  | C5 | CAP CER 10UF 25V X5R 0603 | Cap0603 | GRM188R61E106MA73D | Samsung | C91606 | 10uF | 1 | 10
4 |  | C8, C25, C26, C27, C28, C39, C40, C50 | CAP CER 20PF 50V C0G/NPO 0402 | Cap 0402 | CC0402JRNPO9BN200 | Yageo | C107000 | 20pF | 8 | 100
5 |  | C9, C33 | 16V 4.7uF ±20% 0402 Multilayer Ceramic Capacitors MLCC | Cap 0402 | EDK105BBJ475MVLF | Taiyo Yuden | C412302 | 4.7uF | 2 | 50
6 |  | C16, C32, C43, C45, C46, C48, C51 | CAP CER 1UF 16V X5R 0402 | Cap 0402 | CC0402KRX5R7BB105 | Yageo | C325464 | 1uF | 7 | 50
7 |  | C17 | CAP CER 2.2UF 25V X5R 0402 | Cap 0402 | GRM155R61E225KE11D | Murata | C385032 | 2.2uF | 1 | 10
8 |  | C37 | CAP CER 100pF 50V C0G 0402 | Cap 0403 | GCM1555C1H101JA16D | Murata | C126492 | 100pF | 1 | 50
9 |  | C44 | CAP CER 1000PF 25V X7R 0402 | Cap 0402 | CC0402KRX7R8BB102 | Yageo | C541372 | 1nF | 1 | 100
10 |  | C38 | CAP CER 0.8PF 50V C0G/NP0 0402 | Cap 0402 | GJM1555C1HR80WB01D | Murata | C88902 | 0.8pF | 1 | 20
11 | Connector | J1 | CONN U.FL RCPT STR 50 OHM SMD | Custom | U.FL-R-SMT-1(80) | Hirose | C88374 | --------- | 1 | 10
12 |  | J4 | CONN RCP USB3.1 TYPEC 24P SMD RA | Custom | 2305018-2 | TE Connectivity AMP | C498674 | --------- | 1 | 6
13 |  | ~~J3~~ | ~~CONN HEADER VERT 2POS 1.5MM~~ | ~~Custom~~ | ~~B2B-ZR(LF)(SN)~~ | ~~JST~~ | ~~C158011~~ | ~~---------~~ | ~~1~~ | ~~20~~ | ~~DO NOT MOUNT~~
14 |  | J2 | Clamshell 22 Double-sided contacts/up and down connection Surface Mount 0.5mm SMD,P=0.5mm FFC/FPC Connectors ROHS | Custom | F0504-H-22-20T-R | XFCN | C557729 | --------- | 1 | 6
15 |  | J5 | CONN HEADER VERT 8POS 2.54MM | SMD Header 1x8 | 61300811121 | Wurth Electronics | C2935914 | --------- | 1 | 10
16 |  | J6 | CONN FPC/FFC 12POS .5MM | Custom | FH34SRJ-12S-0.5SH(50) | Hirose | C424659 | --------- | 1 | 6
17 |  | J7 | CONN HEADER VERT 4POS 2.54MM | HDR1X4 SMD | 61300411121 | Wurth Electronics | C2935910 | --------- | 1 | 20
18 | Inductor | L1 | FIXED IND 2.2UH 1.5A 160MOHM SMD | Custom | MAKK2016T2R2M | Taiyo Yuden | ------- | 2.2uH | 1 | 7
19 |  | L3 | 500mA 10uH ±20% 320mΩ 0805 Inductors (SMD) ROHS | Ind0805 | MGFL2012F100MT-LF | microgate | C281113 | 10uH | 1 | 10
20 |  | L4 | 550mA 15nH ±5% 150mΩ SMD,1.68x1x0.85mm Inductors (SMD) ROHS | Custom | SCW1608C15NJST | Sunltech | C231879 | 15nH | 1 | 10
21 |  | L5 | Inductor RF Chip Wirewound 3.9nH 0.2nH 100MHz 38Q-Factor 1A 32mOhm DCR 0603 Paper T/R | IND 0603 | LQW18AN3N9C10D | Murata | C521237 | 3.9nH | 1 | 10
22 |  | L6 | FERRITE BEAD 30 OHM 0603 1LN / Ferrite Beads Multi-Layer 30Ohm 100MHz 1A 0.05Ohm DCR 0603 T/R | IND 0603 | BLM18PG300SN1D | Murata | C17305 | ---------- | 1 | 50
23 |  | L8 | 2.7A 6.8uH ±20% 50mΩ SMD Power Inductors ROHS | Custom | LVC505040-6R8M-N | Chlisin Elec | C285870 | 6.8uH | 1 | 10
24 | LED | LED1, LED3 | LED GREEN CLEAR CHIP SMD | LED 0402 | SZYY0402YG | SunLED | C434449 | ---------- | 2 | 50
25 |  | LED2 | LED RED CLEAR CHIP SMD | LED 0402 | 16-213/SDRC/S530-A3/TR8 | SunLED | C71911 | ---------- | 1 | 10
26 | Resistor | R1 | RES SMD 25m Ohms 125mW 0805 | Res0805 | 0805W8F250MT5E | UNI-ROYAL | C620515 | 0.25R | 1 | 50
27 |  | R2, R3, R9, R28 | RES 1K OHM 5% 1/16W 0402 | Res0402 | RC0402JR-071KL | Yageo | C105637 | 1K | 4 | 100
28 |  | R4, R5, R6, R12, R18, R19, R22, R23, R25, R27 | RES SMD 10K OHM 1% 1/16W 0402 | Res0402 | RC0402FR-0710KL | Yageo | C60490 | 10K | 10 | 100
29 |  | R7, R8, R13, R14, R15, R16, R17, R26 | RES SMD 100K OHM 1% 1/5W 0402 | Res0402 | 0402WGF1003TCE | Panasonic | C25741 | 100K | 8 | 100
30 |  | R10, R11 | RES SMD 4.7K OHM 5% 1/10W 0402 | Res0402 | AC0402JR-074K7L | Panasonic | C144709 | 4.7K | 2 | 100
31 |  | R20, R21 | RES 5.1K OHM 1% 1/10W 0603 | Res0603 | RMC06035.1K1%N | Stackpole Electronics | C269716 | 5.1K | 2 | 100
32 |  | R24 | RES SMD 0402 10.7kOhm 0.5% Paper T/R | Res0402 | AC0402DR-0710K7L | Yageo | C226678 | 10.7K | 1 | 50
33 | Solder Bridge | ~~SB1, SB2, SB3~~ | ~~Solder Bridge ON~~ | ~~Solder Bridge~~ | ~~----------~~ | ~~----------~~ | ~~--------~~ | ~~----------~~ | ~~3~~ | ~~---------~~ | ~~DO NOT MOUNT~~
34 | Switch | SW1, SW2 | 3mm 2mm Round Button 50mA Top3.65mm SPST 12V SMD Tactile Switches | Custom | TS-1185EC-C-D-B | XKB | C318893 | ---------- | 2 | 10
35 | ICs | U1 | 2.1A, 1- OR 2-CELL LI-ION BATTER | QFN(3X3) | MP2615CGQ-Z | Monolithic Power Systems | -------- | ---------- | 1 | 6
36 |  | U2 | IC MPU/RESET CIRC SOT23-3 | SOT-23 | MAX809SEUR+T | Maxim | C7270 | ---------- | 1 | 6
37 |  | U3 | IC PWR SWITCH P-CH 1:1 SUPERSOT6 | SuperSOT™-6 | FDC6330L | ON Semiconductor / Fairchild | -------- | ---------- | 1 | 6
38 |  | U4 | Buck Switching Regulator IC Positive Fixed 3.3V 1 Output 1A 8-WFDFN Exposed Pad | 8-WSON (2x2) | TPS62162DSGR | Texas Instruments | C40256 | ---------- | 1 | 6
39 |  | U5 | IC MCU 32BIT 512KB FLASH 64QFN | QFN64 | ATSAM4S8BA-MU | Microchip | --------- | ---------- | 1 | 6
40 |  | U6 | IC RF TXRX+MCU BLUETOOTH 32WFQFN | 32 QFN | NRF52810-QCAA-R | Nordic Semiconductor | C519278 | ---------- | 1 | 6
41 |  | U7 | iNEMO Inertial Module: 3D Accelerometer and 3D Gyroscope, 1.71V to 3.6V, -40°C to 85°C, VFLGA-14L, RoHS | 14-LGA (2.5x3) | LSM6DSRTR | STMicroelectronics | C784817 | ---------- | 1 | 6
42 |  | U8 | 300mA 75dB@1kHz 10nA 90mV 2.8V~2.8V 2 6V SOT-23-6 Linear Voltage Regulators (LDO) ROHS | SOT-23-6 | VRD2828PTX | AnaSem | C697937 | ---------- | 1 | 10
43 | Crystal | X1, X4 | 32.768kHz SMD Crystal Resonator 12.5pF ±20ppm -40℃~+85℃ SMD3215-2P Crystals ROHS | Custom | X321532768KGD2SI | Yangxing Tech | C620155 | 32.768kHz | 2 | 11
44 |  | X2 | 16MHz SMD Crystal Resonator 12pF ±10ppm ±30ppm -40℃~+85℃ SMD3225-4P Crystals ROHS | Custom | X322516MOB4SI | Yangxing Tech | C12668 | 16MHz | 1 | 10
45 |  | X3 | 32MHz SMD Crystal Resonator 12pF 40Ω ±10ppm ±20ppm -40℃~+85℃ SMD3225-4P Crystals ROHS | Custom | XC32M4-32.000-F12NLDT | HCI | C2905357 | 32MHz | 1 | 10
 |  | Approved
 |  | Notes
