eSpark-Backup/manar-harake-s-e-m-g-device/Deliverables/BOM/Electrode-Board/CLient_BOM_Electrode_Board.xlsx

 | Component list |  | Bill of Materials for Project [Electrode_Board.PrjPcb] (No PCB Document Selected)
 | Source Data From: |  | Electrode_Board.PrjPcb
 | Project: |  | Electrode_Board.PrjPcb
 | Variant: |  | None
# | Designator | Description | Footprint | Manufacturer Part Number | Manufacturer | Comment | Quantity (1 Board) | Quantity 40 Board | Remarks
1 | C1 | CAP CER 10UF 25V X5R 0603 | Cap0603 | CL10A106MA8NRNC | Samsung | 10uF' | 1 | 40
2 | C2 | CAP CER 0.1UF 50V X7R 0402 | Cap 0402 | GRM155R71H104ME14D | Murata | 0.1uF | 1 | 40
3 | C3 | CAP CER 10nF 50V 0402 SMD | Cap 0402 |  |  | 10nF | 1 | 40
4 | C4 | CAP CER 1UF 16V X5R 0402 | Cap 0402 | CC0402KRX5R7BB105 | Yageo | 1uF | 1 | 40
5 | D1, D2 | 100V -55℃~+150℃@(Tj) 400mW Single 1.25V@150mA 4ns 1μA@75V 200mA SOD-323 Switching Diode ROHS | SOD-323 | 1N4148WS | YFW | ------- | 2 | 80
6 | ~~P1~~ | ~~Sensor Connecting Pads~~ | ~~sEMG sensor~~ | ~~-------~~ | ~~-------~~ | ~~-------~~ | ~~1~~ | ~~40~~ | Do Not Mount
7 | ~~P9~~ | ~~Ribbon wire Connection Pads~~ | ~~Custom~~ | ~~6 pin Ribbon Pads.~~ | ~~-------~~ | ~~-------~~ | ~~1~~ | ~~40~~ | Do Not Mount
8 | R1 | RES SMD 0402 240 Ohm 1% 1/16W ±100ppm/°C Molded SMD Paper T/R | Res0402 | RC0402FR-07240RL | Yageo | 240R | 1 | 40
9 | R2, R3, R4, R5, R6 | RES SMD 0402 150kOhm 5% Paper T/R | Res0402 | RC0402JR-07150KL | Yageo | 150K | 5 | 200
10 | R7, R8 | 1/16W 50V ±1% ±200ppm/℃ -55℃~+155℃ 80.6kΩ 0402 Chip Resistor - Surface Mount ROHS | Res0402 | RC-02W8062FT | FH | 80.6K | 2 | 80
11 | R9 | TRIMMER 100K OHM 0.1W J LEAD TOP | TC33X-2-104E | TC33X-2-104E | Bourns | 100K | 1 | 40
12 | R10 | RES 1K OHM 5% 1/16W 0402 | Res0402 | RC0402JR-071KL | Yageo | 1K | 1 | 40
13 | U1 | IC OPAMP INSTR 825KHZ 8SOIC | SOIC-8 | AD8221ARZ-R7 | Analog Devices | ------- | 1 | 40
14 | U2 | IC OPAMP JFET 4 CIRCUIT 14TSSOP | 14TSSOP | TL084CPWR | Texas Instruments | ------- | 1 | 40
 | Approved
 | Notes
