eSpark-Backup/manar-harake-s-e-m-g-device/Deliverables/BOM/Electrode-Board/eSpark_BOM_Electrode_Board.xlsx

 | Component list |  | Bill of Materials for Project [Electrode_Board.PrjPcb] (No PCB Document Selected)
 | Source Data From: |  | Electrode_Board.PrjPcb
 | Project: |  | Electrode_Board.PrjPcb
 | Variant: |  | None
# | Designator | Description | Footprint | Manufacturer Part Number | Alternate Part No | Manufacturer | LCSC/Part No | Comment | Quantity (1 Board) | Quantity/40 Boards | LCSC/MOQ/40 Boards | Links | Unit Cost/40 Boards | Total Cost/40 Boards | Remarks | Reviewer Remarks
1 | C1 | CAP CER 10UF 25V X5R 0603 | Cap0603 | ~~CL10A106MA8NRNC~~ | GRM188R61E106MA73D | Samsung | C91606 | 10uF | 1 | 40 | 50 | LCSC (https://lcsc.com/product-detail/Multilayer-Ceramic-Capacitors-MLCC-SMD-SMT_Murata-Electronics-GRM188R61E106MA73D_C91606.html) | $0.0328 | $1.64
2 | C2 | CAP CER 0.1UF 50V X7R 0402 | Cap 0402 | ~~GRM155R71H104ME14D~~ | CL05B104KB54PNC | Murata | C307331 | 0.1uF | 1 | 40 | 50 | LCSC (https://lcsc.com/product-detail/Multilayer-Ceramic-Capacitors-MLCC-SMD-SMT_Samsung-Electro-Mechanics-CL05B104KB54PNC_C307331.html) | $0.0072 | $0.36
3 | C3 | CAP CER 10nF 50V 0402 SMD | Cap 0402 | CC0402KRX7R9BB103 | --------- | Yageo | C60133 | 10nF | 1 | 40 | 100 | LCSC (https://lcsc.com/product-detail/Multilayer-Ceramic-Capacitors-MLCC-SMD-SMT_YAGEO-CC0402KRX7R9BB103_C60133.html) | 0.001 | $0.10
4 | C4 | CAP CER 1UF 16V X5R 0402 | Cap 0402 | CC0402KRX5R7BB105 | --------- | Yageo | C325464 | 1uF | 1 | 40 | 50 | LCSC (https://lcsc.com/product-detail/Multilayer-Ceramic-Capacitors-MLCC-SMD-SMT_YAGEO-CC0402KRX5R7BB105_C325464.html) | $0.0067 | $0.34
5 | D1, D2 | 100V -55℃~+150℃@(Tj) 400mW Single 1.25V@150mA 4ns 1μA@75V 200mA SOD-323 Switching Diode ROHS | SOD-323 | 1N4148WS | --------- | Shikues | C110221 | ---- | 2 | 80 | 100 | LCSC (https://lcsc.com/product-detail/Switching-Diode_Shikues-1N4148WS_C110221.html) | $0.0131 | $1.31
6 | ~~P1~~ | ~~Sensor Connecting Pads~~ | ~~Custom~~ | ~~-------~~ | ~~-------~~ | ~~-------~~ | ~~-------~~ | ~~----~~ | ~~1~~ | ~~40~~ | ~~--------~~ | ~~-------~~ | ~~--------~~ | ~~---------~~ | DO NOT MOUNT | ~~--------~~
7 | ~~P9~~ | ~~Ribbon wire Connection Pads~~ | ~~Custom~~ | ~~6 pin Ribbon Pads.~~ | ~~-------~~ | ~~-------~~ | ~~-------~~ | ~~----~~ | ~~1~~ | ~~40~~ | ~~-------~~ | ~~----~~ | ~~-------~~ | ~~-------~~ | DO NOT MOUNT | ~~----~~
8 | R1 | RES SMD 0402 240 Ohm 1% 1/16W ±100ppm/°C Molded SMD Paper T/R | Res0402 | RC0402FR-07240RL | --------- | Yageo | C114755 | 240R | 1 | 40 | 100 | LCSC (https://lcsc.com/product-detail/Chip-Resistor-Surface-Mount_YAGEO-RC0402FR-07240RL_C114755.html) | $0.0008 | $0.08
9 | R2, R3, R4, R5, R6 | RES SMD 0402 150kOhm 5% Paper T/R | Res0402 | RC0402JR-07150KL | ------- | Yageo | C137919 | 150K | 5 | 200 | 300 | LCSC (https://lcsc.com/product-detail/Chip-Resistor-Surface-Mount_YAGEO-RC0402JR-07150KL_C137919.html) | $0.0005 | $0.15
10 | R7, R8 | 1/16W 50V ±1% ±200ppm/℃ -55℃~+155℃ 80.6kΩ 0402 Chip Resistor - Surface Mount ROHS | Res0402 | RC-02W8062FT | --------- | FH | C304637 | 80.6K | 2 | 80 | 100 | LCSC (https://lcsc.com/product-detail/Chip-Resistor-Surface-Mount_FH-Guangdong-Fenghua-Advanced-Tech-RC-02W8062FT_C304637.html) | $0.0007 | $0.07
11 | R9 | TRIMMER 100K OHM 0.1W J LEAD TOP | Custom | TC33X-2-104E | ------- | Bourns | C719186 | 100K | 1 | 40 | 45 | LCSC (https://lcsc.com/product-detail/Variable-Resistors-Potentiometers_BOURNS-TC33X-2-104E_C719186.html) | $0.1821 | $8.19
12 | R10 | RES 1K OHM 5% 1/16W 0402 | Res0402 | RC0402JR-071KL | --------- | Yageo | C105637 | 1K | 1 | 40 | 100 | LCSC (https://lcsc.com/product-detail/Chip-Resistor-Surface-Mount_YAGEO-RC0402JR-071KL_C105637.html) | $0.0006 | $0.06
13 | U1 | IC OPAMP INSTR 825KHZ 8SOIC | SOIC-8 | AD8221ARZ-R7 | ------- | Analog Devices | -------- | ---- | 1 | 40 | 42 | ------- | $4.7250 | $198.45 | Need Fresh Quotation From Custom Supplier | Quote added from Lulu
14 | U2 | IC OPAMP JFET 4 CIRCUIT 14TSSOP | 14TSSOP | TL084CPWR | --------- | Texas Instruments | C85344 | ---- | 1 | 40 | 42 | LCSC (https://lcsc.com/product-detail/FET-InputAmplifiers_Texas-Instruments-TL084CPWR_C85344.html) | $0.3337 | $14.02
 | Approved |  |  |  |  |  |  |  |  |  | Total Component Cost |  |  | $224.76
 | Notes |  |  |  |  |  |  |  |  |  | Single Board Cost |  |  | $5.62
