eSpark-Backup/manar-harake-s-e-m-g-device/Deliverables/BOM/Sensor-Board/eSpark_BOM-Sensor-Board.xlsx

 | Component list |  | Bill of Materials for Project [ArmBand-Sensor-Board.PrjPcb] (No PCB Document Selected)
 | Source Data From: |  | ArmBand-Sensor-Board.PrjPcb
 | Project: |  | ArmBand-Sensor-Board.PrjPcb
 | Variant: |  | None
# | Designator | Description | Footprint | Manufacturer Part Number | Alternate Part No | Manufacturer | LCSC/Part No | Comment | Quantity (1 Board) | Quantity (5Boards) | LCSC/MOQ/5 Boards | Links | Unit Cost/5 Boards | Total Cost/5 Boards | Remarks | Reviewer Remarks
1 | C1, C60 | CAP CER 0.1UF 50V X7R 0402 | Cap 0402 | ~~GRM155R71H104ME14D~~ | CL05B104KB54PNC | Murata | C307331 | 0.1uF | 2 | 10 | 50 | LCSC (https://lcsc.com/product-detail/Multilayer-Ceramic-Capacitors-MLCC-SMD-SMT_Samsung-Electro-Mechanics-CL05B104KB54PNC_C307331.html) | $0.0072 | $0.3600
2 | C51, C52 | CAP CER 1UF 16V X5R 0402 | Cap 0402 | CC0402KRX5R7BB105 | -------- | Yageo | C325464 | 1uF | 2 | 10 | 50 | LCSC (https://lcsc.com/product-detail/Multilayer-Ceramic-Capacitors-MLCC-SMD-SMT_YAGEO-CC0402KRX5R7BB105_C325464.html) | $0.0067 | $0.3350
3 | J1 | Slide Lock 32 Bottom Contact Surface Mount 0.5mm SMD,P=0.5mm FFC/FPC Connectors ROHS | Custom | AFC07-S32FCA-00 | -------- | JUSHUO | C262570 | ---------- | 1 | 5 | 6 | LCSC (https://lcsc.com/product-detail/FFC-FPC-Connectors_JUSHUO-AFC07-S32FCA-00_C262570.html) | $0.1598 | $0.9588
4 | J2 | CONN FPC/FFC 12POS .5MM | Custom | FH34SRJ-12S-0.5SH(50) | -------- | Hirose | C424659 | ---------- | 1 | 5 | 6 | LCSC (https://lcsc.com/product-detail/FFC-FPC-Connectors_HRS-Hirose-FH34SRJ-12S-0-5SH-50_C424659.html) | $0.1893 | $1.1358
5 | ~~P1, P3, P5, P7, P9, P11, P13, P15, P16, P18, P20~~ | ~~Test Point ON~~ | ~~Custom~~ | ~~----------~~ | ~~--------~~ | ~~----------~~ | ~~--------~~ | ~~----------~~ | ~~11~~ | ~~55~~ | ~~----------~~ | ~~--------~~ | ~~----------~~ | ~~----------~~ | DO NOT MOUNT
6 | R1, R2 | RES SMD 10K OHM 1% 1/16W 0402 | Res0402 | RC0402FR-0710KL | -------- | Yageo | C60490 | 10K | 2 | 10 | 100 | LCSC (https://lcsc.com/product-detail/Chip-Resistor-Surface-Mount_YAGEO-RC0402FR-0710KL_C60490.html) | 0.0006 | $0.0600
7 | R25, R26 | 1/10W Thin Film Resistor 75V ±0.5% ±25ppm/℃ -55℃~+155℃ 64kΩ 0603 Chip Resistor - Surface Mount ROHS | Res0603 | ARG03DTC6402N | -------- | iking Tech | C2902643 | 64K | 2 | 10 | 50 | LCSC (https://lcsc.com/product-detail/Chip-Resistor-Surface-Mount_Viking-Tech-ARG03DTC6402N_C2902643.html) | $0.0127 | $0.6350
8 | SW1, SW2 | No Gull Wing 50mA 100MΩ 80000 260gf@±50gf 12V -25℃~+85℃ 1.7mm Golden Round Button Brick nogging SPST SMD Tactile Switches ROHS | Custom | TC-0522C-1.7-260G | -------- | HCTL | C2845290 | ---------- | 2 | 10 | 50 | LCSC (https://www.lcsc.com/product-detail/Tactile-Switches_HCTL-TC-0522C-1-7-260G_C2845290.html) | $0.0190 | $0.9500
9 | U16 | SOT-23-5 Operational Amplifier ROHS | SOT-23-5 | TPMCP6021T-E/OT | -------- | TECH PUBLIC | C2923365 | ---------- | 1 | 5 | 6 | LCSC (https://lcsc.com/product-detail/Operational-Amplifier_TECH-PUBLIC-TPMCP6021T-E-OT_C2923365.html) | $0.4418 | $2.6508
10 | U17, U18 | IC OPAMP GP 1.3MHZ 14SO | SO-14 | LM324DT | -------- | STMicroelectronics | C71035 | ---------- | 2 | 10 | 11 | LCSC (https://lcsc.com/product-detail/Operational-Amplifier_STMicroelectronics-LM324DT_C71035.html) | $0.1229 | $1.3519
 | Approved |  |  |  |  |  |  |  |  |  | Total Component Cost |  |  | $8.44
 | Notes |  |  |  |  |  |  |  |  |  | Single Board Cost |  |  | $1.69
