eSpark-Backup/manar-harake-s-e-m-g-device/Deliverables/BOM/Sensor-Board/PCBWay_BOM-Sensor-Board.xlsx

 |  | Component list |  | Bill of Materials for Project [ArmBand-Sensor-Board.PrjPcb] (No PCB Document Selected)
 |  | Source Data From: |  | ArmBand-Sensor-Board.PrjPcb
 |  | Project: |  | ArmBand-Sensor-Board.PrjPcb
 |  | Variant: |  | None
# | Item Type | Designator | Description | Footprint | Manufacturer Part Number | Manufacturer | LCSC/Part No | Comment | Quantity (1 Board) | LCSC/MOQ/5 Boards | Remarks
1 | Capacitor | C1, C60 | CAP CER 0.1UF 50V X7R 0402 | Cap 0402 | CL05B104KB54PNC | Murata | C307331 | 0.1uF | 2 | 50
2 |  | C51, C52 | CAP CER 1UF 16V X5R 0402 | Cap 0402 | CC0402KRX5R7BB105 | Yageo | C325464 | 1uF | 2 | 50
3 | Connector | J1 | Slide Lock 32 Bottom Contact Surface Mount 0.5mm SMD,P=0.5mm FFC/FPC Connectors ROHS | Custom | AFC07-S32FCA-00 | JUSHUO | C262570 | -------- | 1 | 6
4 |  | J2 | CONN FPC/FFC 12POS .5MM | Custom | FH34SRJ-12S-0.5SH(50) | Hirose | C424659 | ---------- | 1 | 6
5 |  | ~~P1, P3, P5, P7, P9, P11, P13, P15, P16, P18, P20~~ | ~~Test Point ON~~ | ~~Custom~~ | ~~----------~~ | ~~----------~~ | ~~--------~~ | ~~----------~~ | ~~11~~ | ~~55~~ | ~~DO NOT MOUNT~~
6 | Resistor | R1, R2 | RES SMD 10K OHM 1% 1/16W 0402 | Res0402 | RC0402FR-0710KL | Yageo | C60490 | 10K | 2 | 100
7 |  | R25, R26 | 1/10W Thin Film Resistor 75V ±0.5% ±25ppm/℃ -55℃~+155℃ 64kΩ 0603 Chip Resistor - Surface Mount ROHS | Res0603 | ARG03DTC6402N | iking Tech | C2902643 | 64K | 2 | 50
8 | Switch | SW1, SW2 | No Gull Wing 50mA 100MΩ 80000 260gf@±50gf 12V -25℃~+85℃ 1.7mm Golden Round Button Brick nogging SPST SMD Tactile Switches ROHS | Custom | TC-0522C-1.7-260G | HCTL | C2845290 | ---------- | 2 | 50
9 | Ics | U16 | SOT-23-5 Operational Amplifier ROHS | SOT-23-5 | TPMCP6021T-E/OT | TECH PUBLIC | C2923365 | ---------- | 1 | 6
10 |  | U17, U18 | IC OPAMP GP 1.3MHZ 14SO | SO-14 | LM324DT | STMicroelectronics | C71035 | ---------- | 2 | 11
 |  | Approved
 |  | Notes
