eSpark-Backup/manar-harake-s-e-m-g-device/Deliverables/ArmBand-Control-Board/_Supporting Files/ArmBand-Control-Board.step

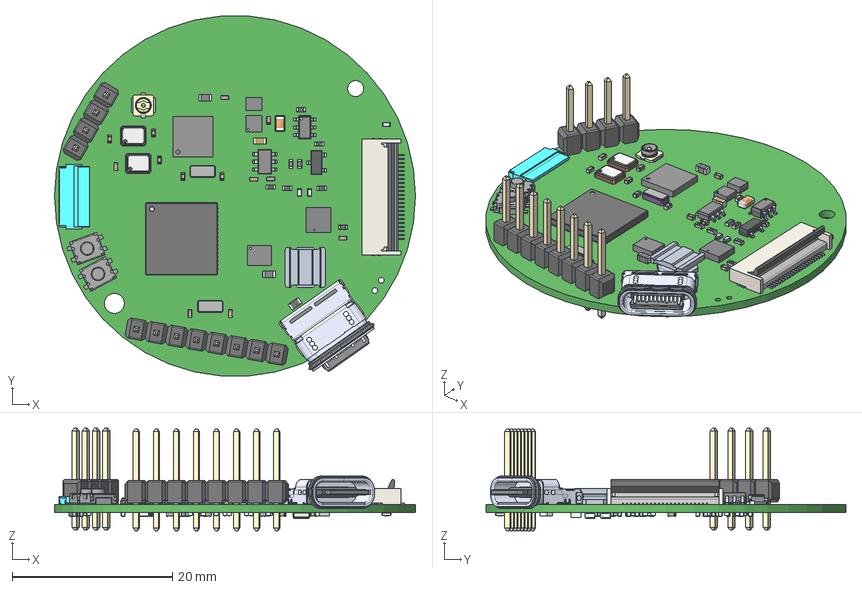
[picture p16: CAD file, 2022-07-19]
Deliverables/ArmBand-Control-Board/_Supporting Files/ArmBand-Control-Board.step
45.0 x 44.9 x 12.8 mm
ts-1185ec-c-d-b_RGB6710886 x 2
FH34SRJ-12S-0.5SH
F0504-H-22-20T_(1)
MetalFrame x 2
Pin1Marker x 2
Pin3 x 2
Pin1 x 2
Lid x 2
Pin4 x 2
Pin2 x 2
Ceramic x 2
User_Library-CR2012-0805
holder x 2
pin x 12
User_Library-RES_1005-0402 x 25
User_Library-Capacitor_0402 x 45
SSOT_6001
SSOT_6
User_Library-CAPC1608X09
User_Library-FX135A-327 x 2
TPS62162DSGR
NOPB
User_Library-RESC1608X05N x 2
LSM6DS3TR--3DModel-STEP-56544
User_Library-QFN-32-5x5_-_EQ
User_Library-QFN64-2
CircuitWorks-SOT-23
QFN-16_3MM×3MM_MNP_MPS
User_Library-LED-0402 x 3
srn5020-100m
MAKK2016T2R2M
2305018-2--3DModel-STEP-56544
U.FL-R-SMT-1
User_Library-0805_SMD_Capacitor x 3
