eSpark-Backup/manar-harake-s-e-m-g-device/Deliverables/Control-Board-Flexible-PCB/_Supporting Files/Control Board Flexible PCB.DXF

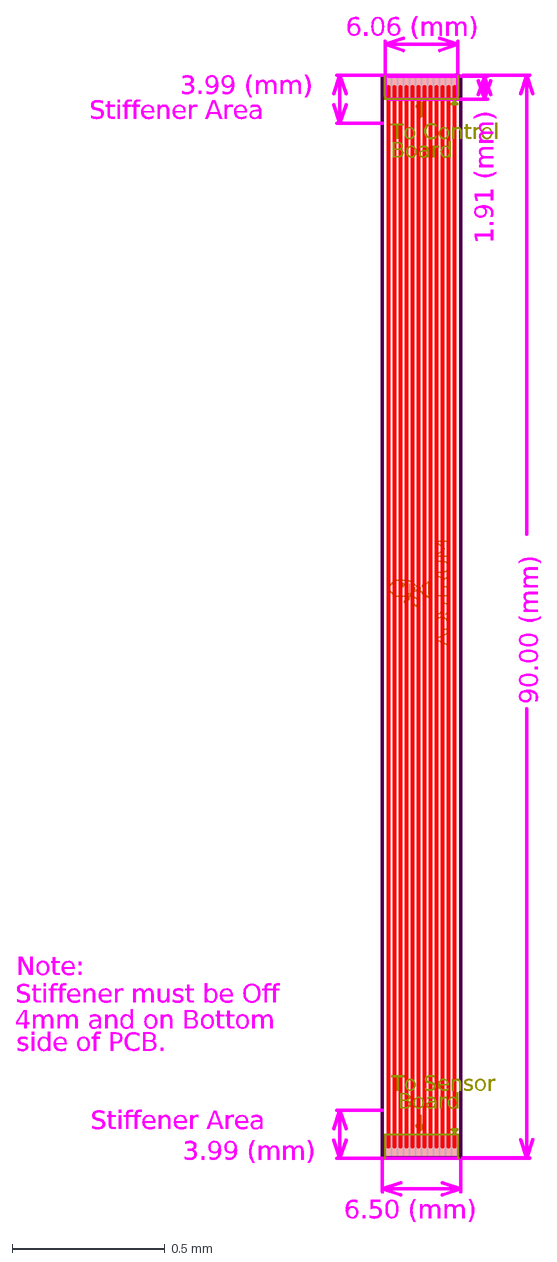
[picture p17: CAD file, 2022-07-19]
Deliverables/Control-Board-Flexible-PCB/_Supporting Files/Control Board Flexible PCB.DXF
Board
To Sensor
To Control
Stiffener Area
side of PCB.
4mm and on Bottom
Stiffener must be Off
Note:
3.99 (mm)
6.06 (mm)
1.91 (mm)
6.50 (mm)
90.00 (mm)
