eSpark-Backup/manar-harake-s-e-m-g-device/Deliverables/Octopus_Ribbon_PCB/_Supporting Files/Oct_Ribbon_V2.1_PCB.step

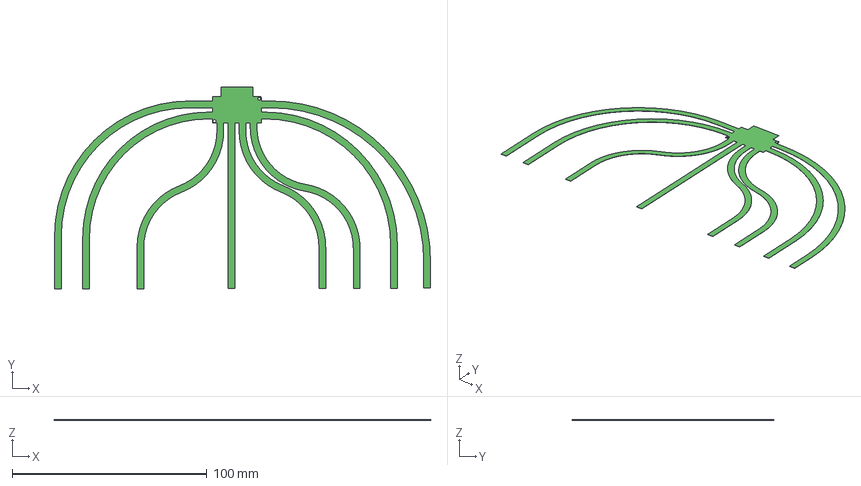
[picture p18: CAD file, 2022-07-19]
Deliverables/Octopus_Ribbon_PCB/_Supporting Files/Oct_Ribbon_V2.1_PCB.step
193.2 x 103.8 x 0.116 mm
