eSpark-Backup/manar-harake-s-e-m-g-device/(list of files, cad)

Other CAD files:
Deliverables/ArmBand-Control-Board/_Supporting Files/ArmBand-Control-Board.DWG
Deliverables/ArmBand-Control-Board/_Supporting Files/ArmBand-Control-Board.DXF
Deliverables/Octopus_Ribbon_PCB/_Supporting Files/Oct_Ribbon_V2.1_PCB.DXF
