eSpark-Backup/manar-harake-s-e-m-g-device/Deliverables/ArmBand-Control-Board/_Schematics/ArmBand-Control-Board.pdf

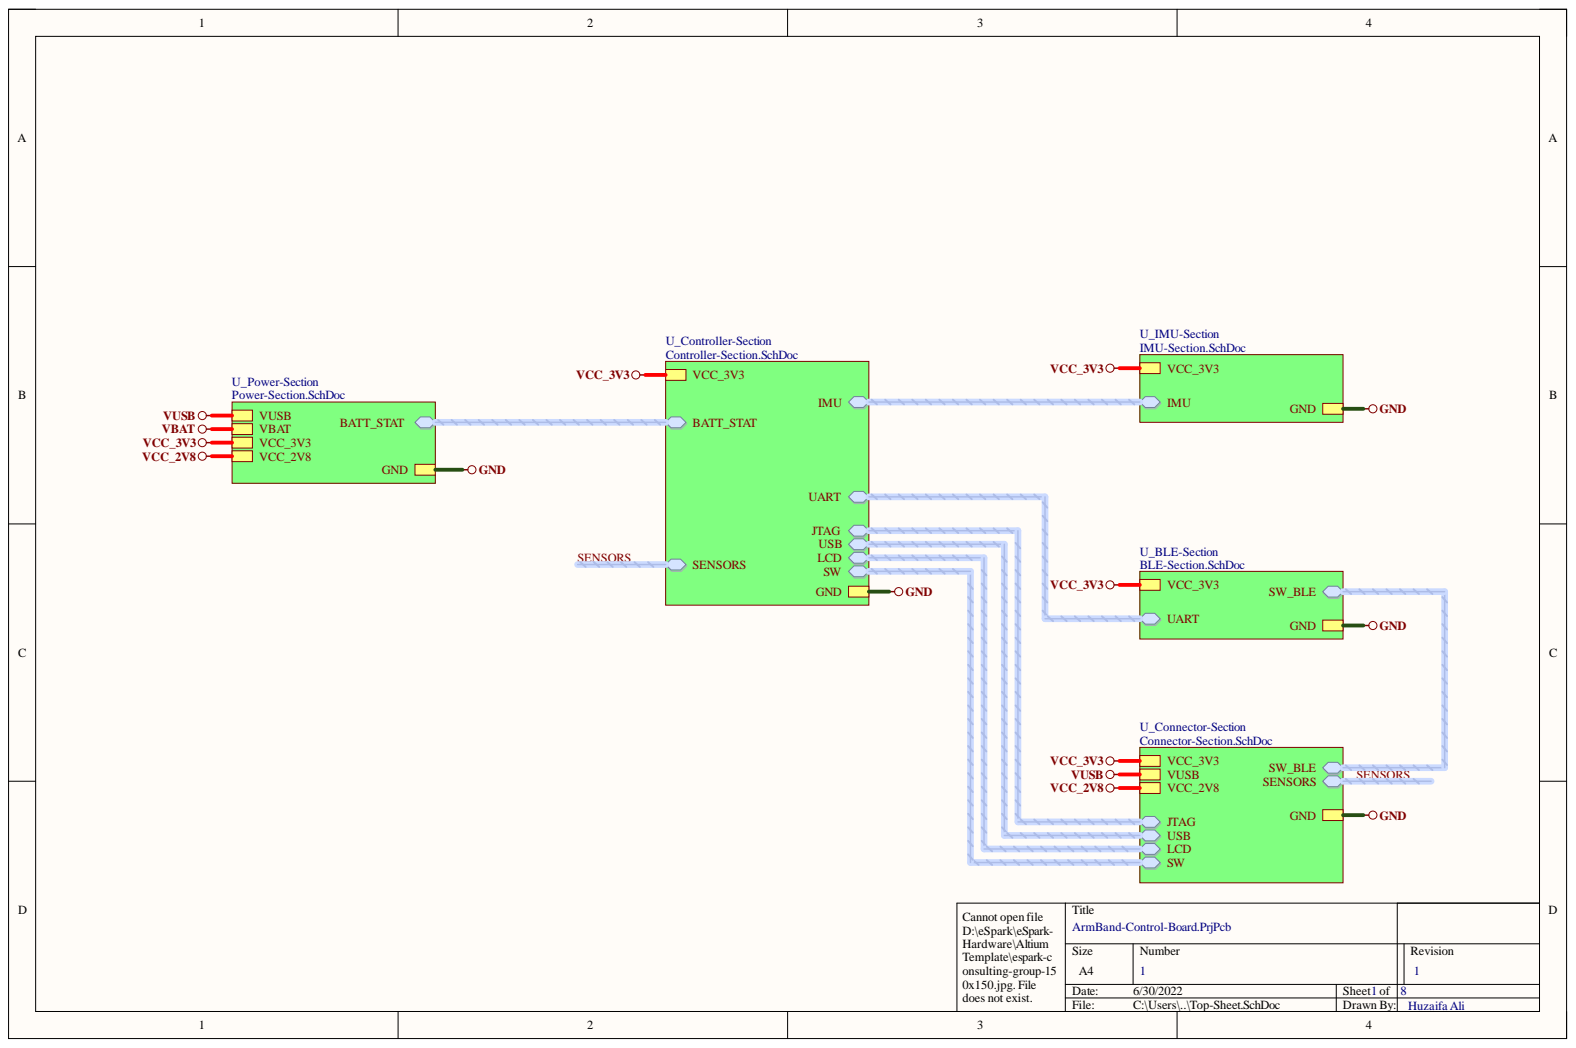
[picture p19: page 1]

Cannot open file D:\eSpark\eSpark-Hardware\Altium Template\espark-c onsulting-group-15 0x150.jpg. File does not exist. | Title ArmBand-Control-Board.PrjPcb

Size A4 | Number 1 | Revision 1

Date: 6/30/2022 | Sheet of 1 | 8
File: C:\Users\..\Top-Sheet.SchDoc | Drawn By: | Huzaifa Ali

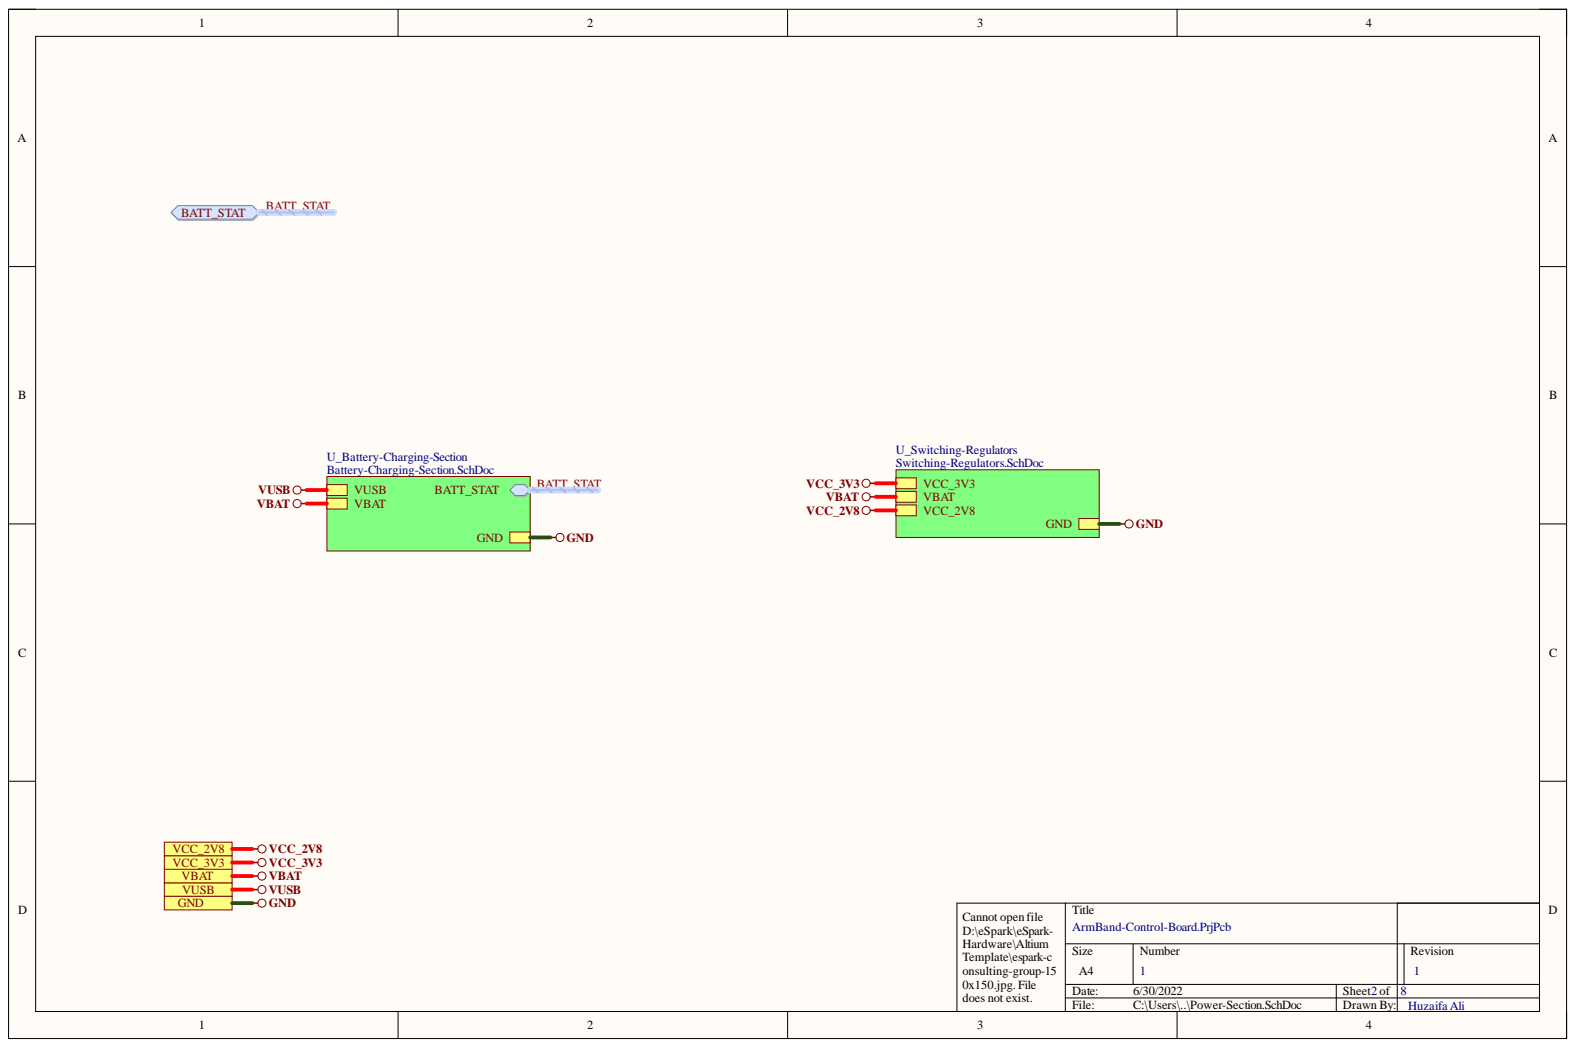
[picture p20: page 2]

U_Battery-Charging-Section
Battery-Charging-Section.SchDoc
VBAT

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

Size A4 | Number 1 | Revision 1

Date: 6/30/2022 | Sheet of 2 | 8
File: C:\Users\..\Power-Section.SchDoc | Drawn By: | Huzaifa Ali

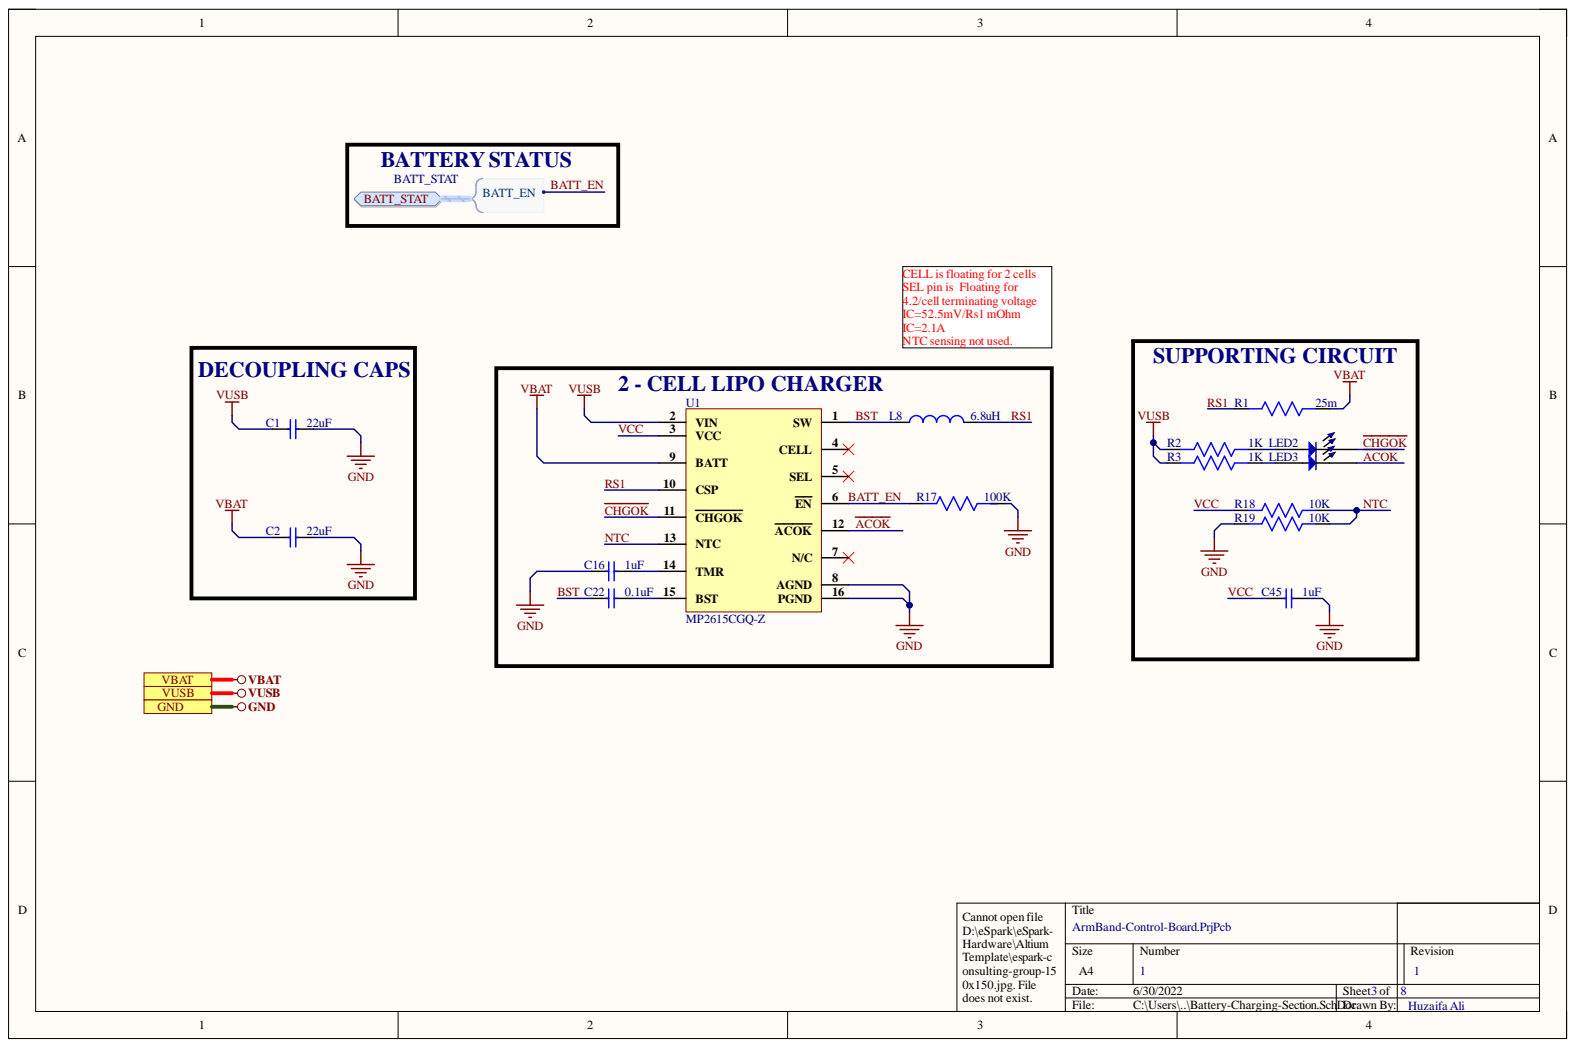
[picture p21: page 3]

CELL is floating for 2 cells
SEL pin is Floating for
4.2/cell terminating voltage
IC=52.5mV/Rs1 mOhm
NTCsensing not used.

2 - CELL LIPO CHARGER DECOUPLING CAPS

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

Size A4 | Number 1 | Revision 1

Date: 6/30/2022 | Sheet of 3 | 8
File: C:\Users\..\Battery-Charging-Section.SchDDr ocawn By: | | Huzaifa Ali

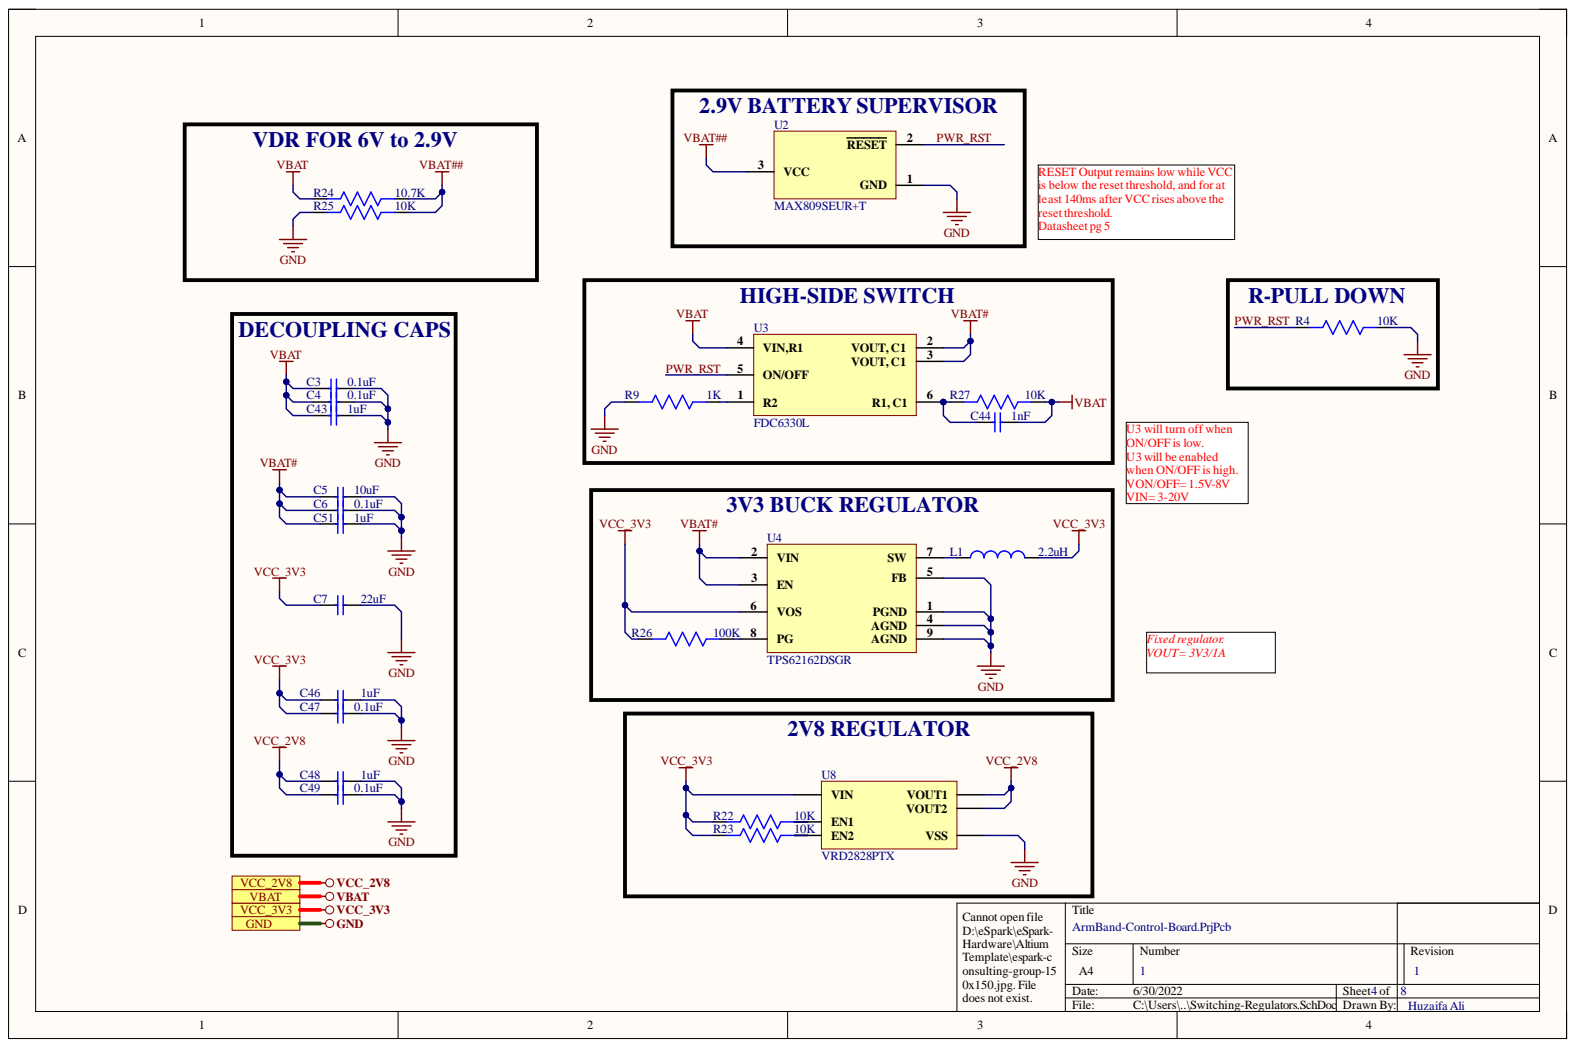
[picture p22: page 4]

RESET Output remains low while VCC
is below the reset threshold, and for at
least 140ms after VCCrises above the
reset threshold.
Datasheet pg 5

U3 will turn off when
ON/OFF is low.
U3 will be enabled
when ON/OFF is high.
VON/OFF= 1.5V-8V
VIN= 3-20V

Title
ArmBand-Control-Board.PrjPcb

Size A4 | Number 1 | Revision 1

Date: 6/30/2022 | Sheet of 4 | 8
File: C:\Users\..\Switching-Regulators.SchDoc | Drawn By: | Huzaifa Ali

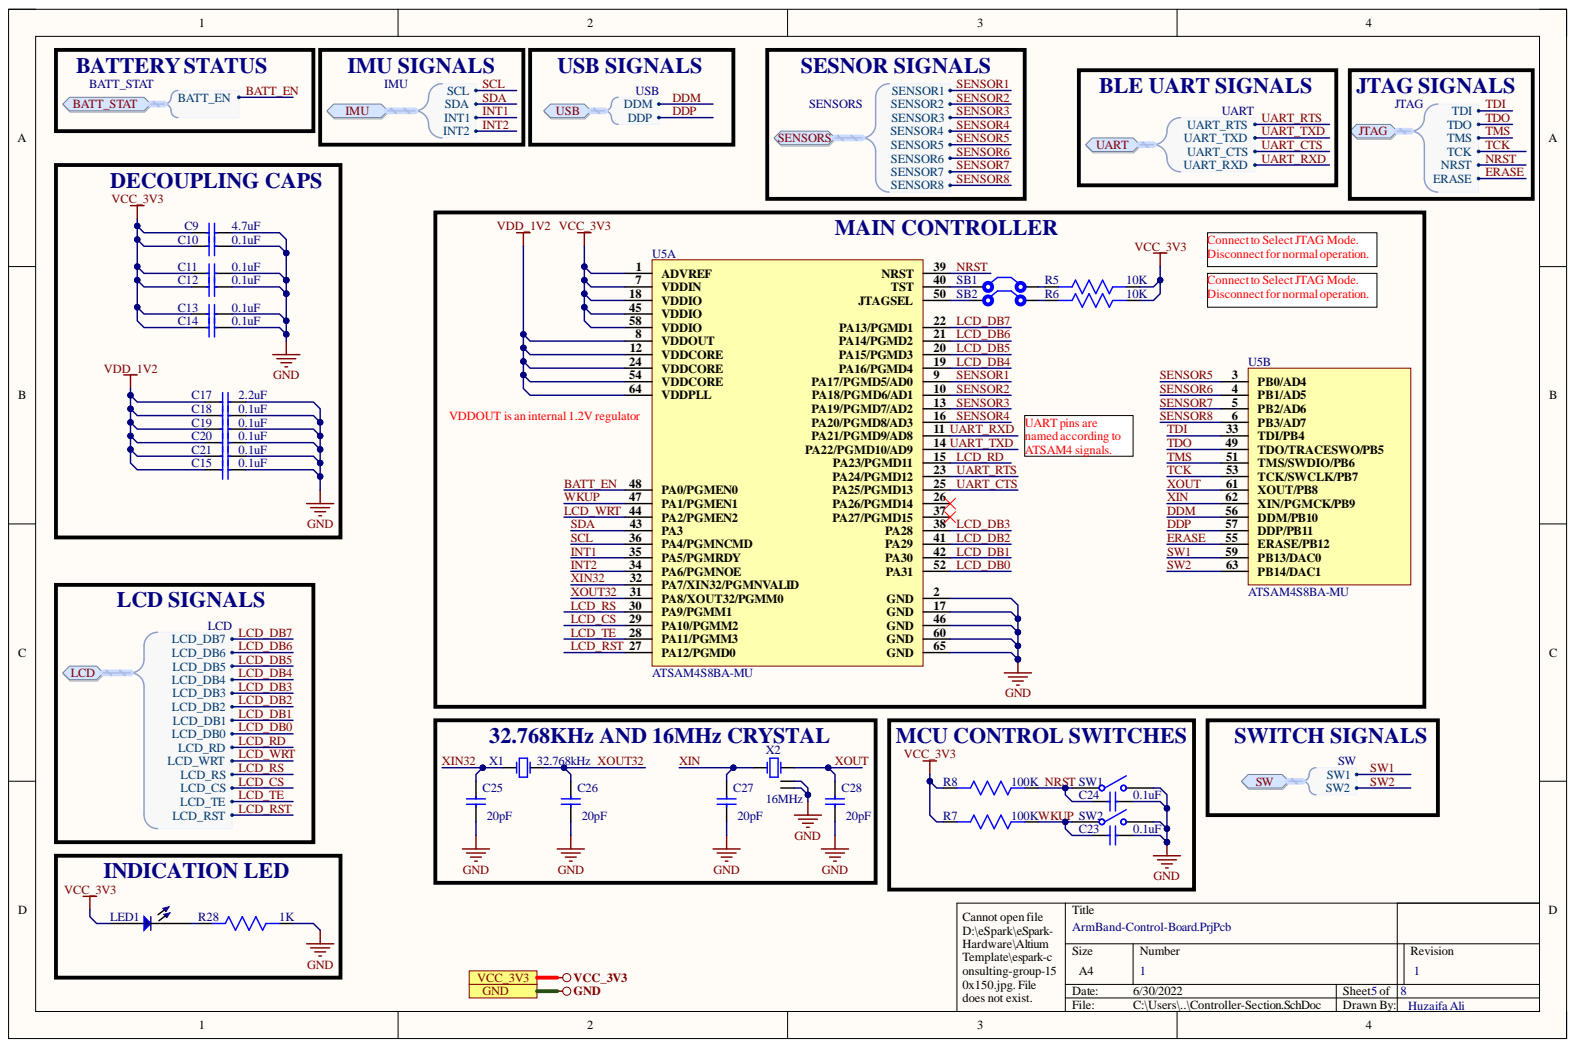
[picture p23: page 5]

Disconnect for normal operation.

Connect to Select JTAG Mode.

VDDOUT is an internal 1.2V regulator

UART_RXD | TDI | TDI/PB4 33
UART_TXD | TDO | TDO/TRACESWO/PB5 49

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

Size A4 | Number 1 | Revision 1

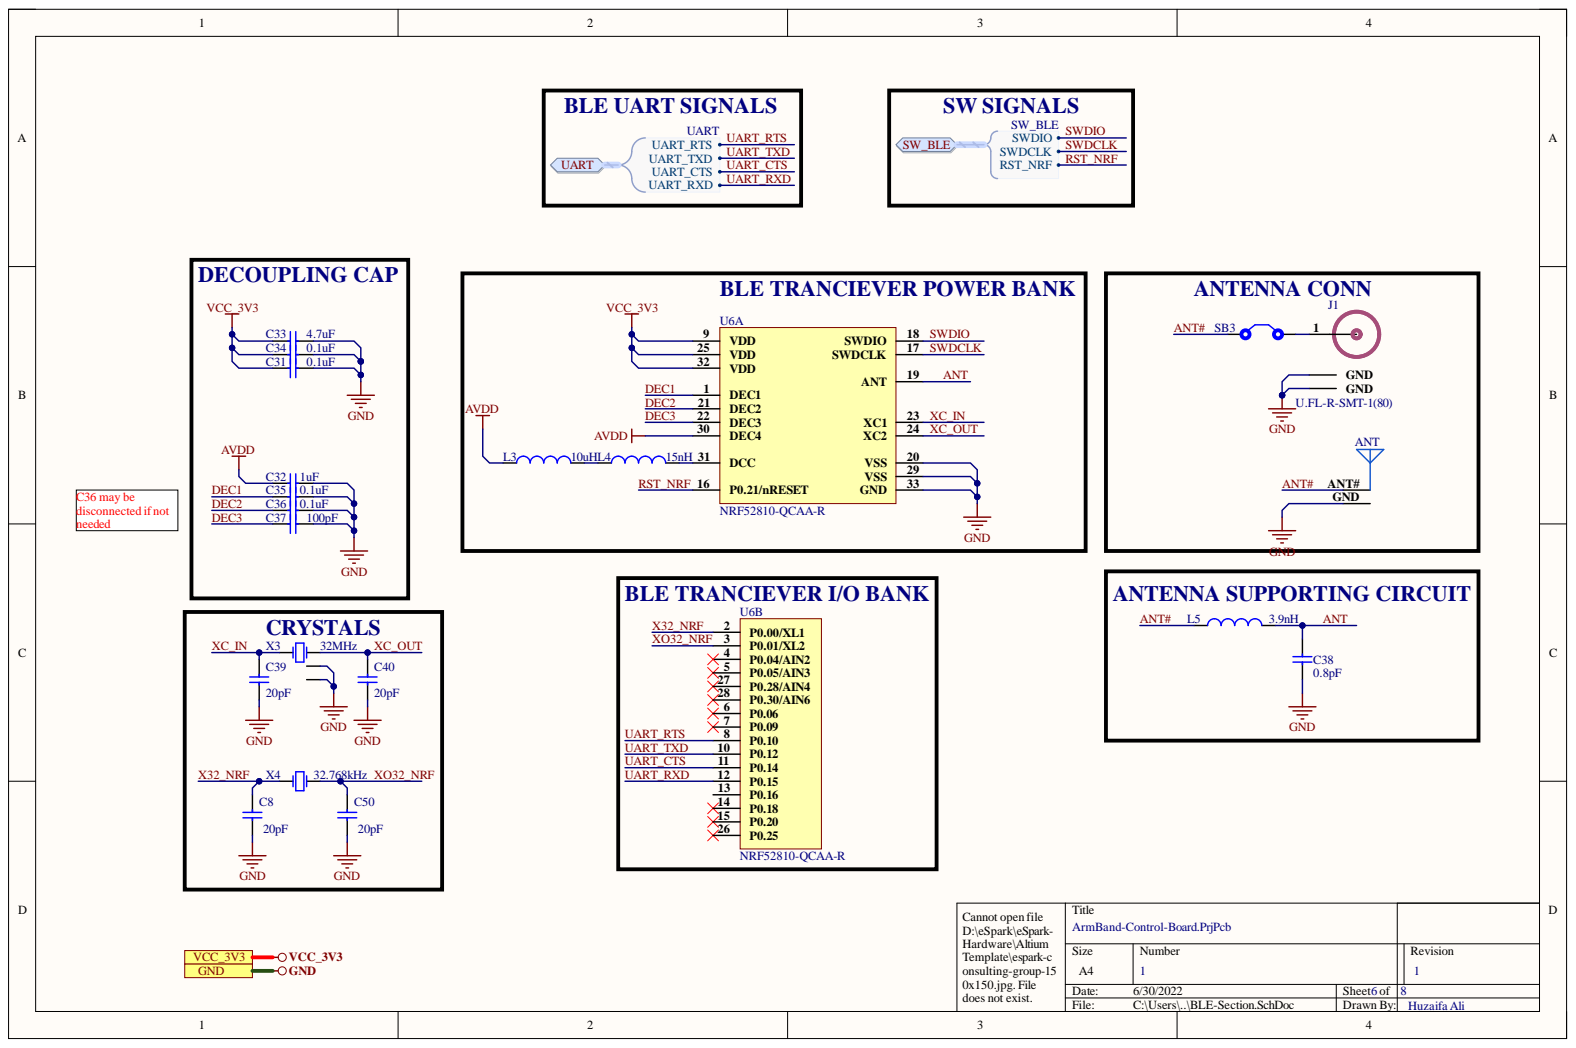
[picture p24: page 6]

BLE TRANCIEVER POWER BANK

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

Size A4 | Number 1 | Revision 1

Date: 6/30/2022 | Sheet of 6 | 8
File: C:\Users\..\BLE-Section.SchDoc | Drawn By: | Huzaifa Ali

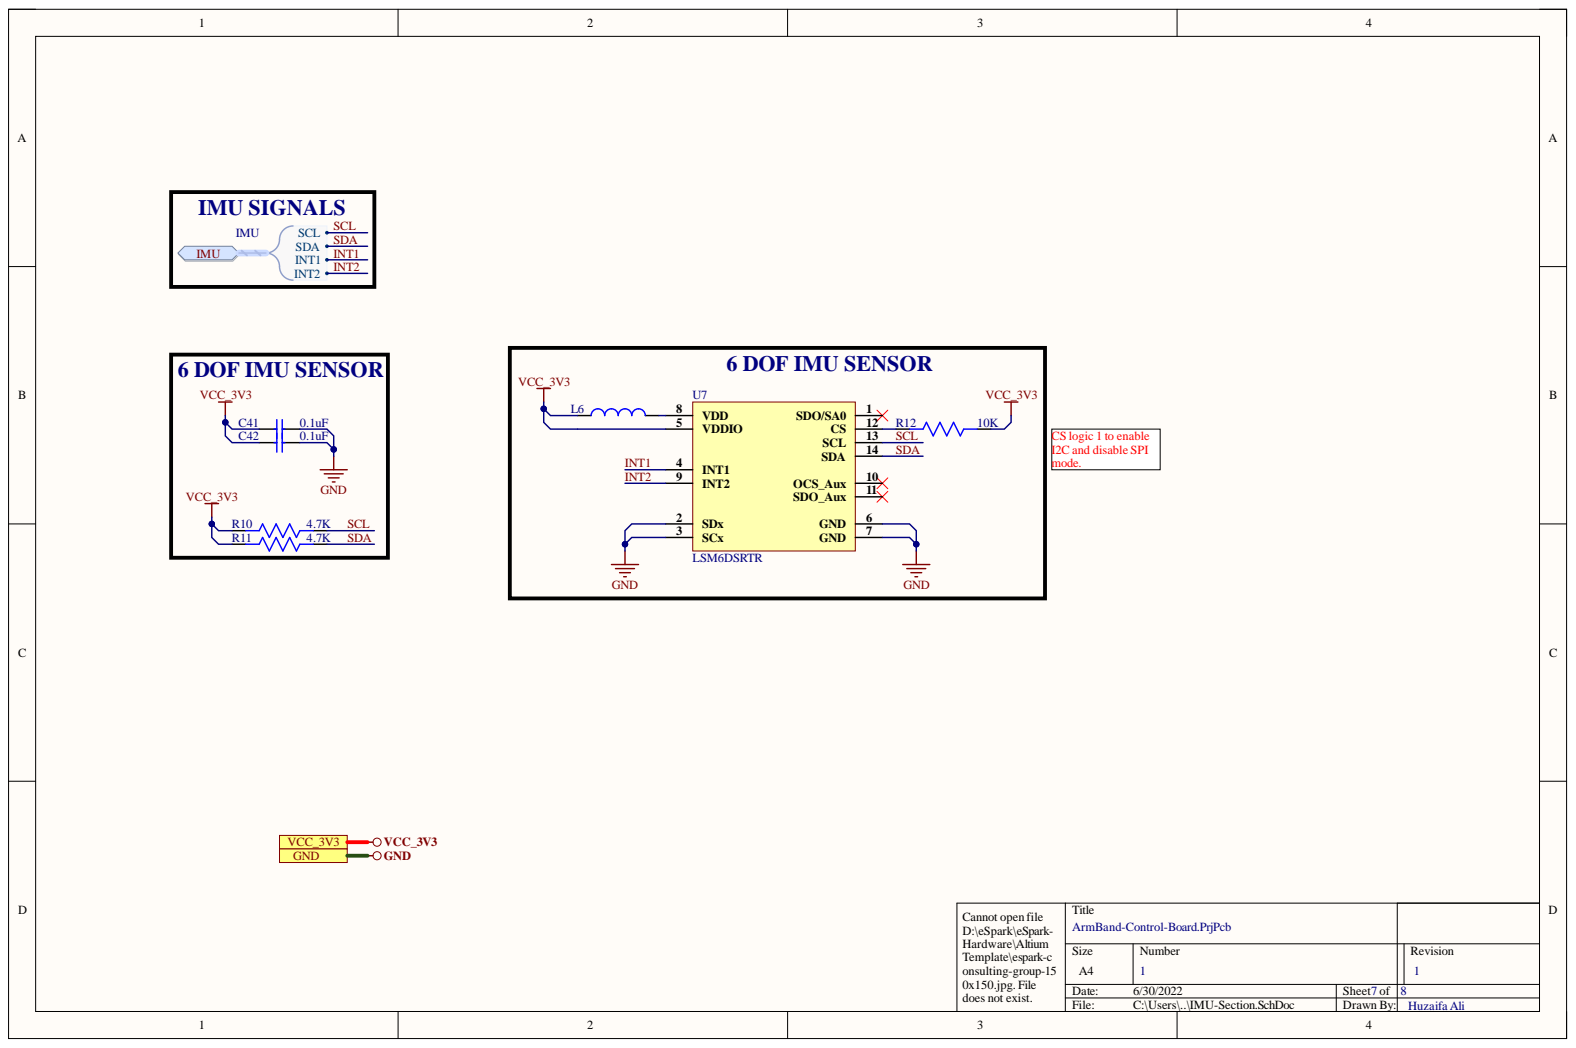
[picture p25: page 7]

CS logic 1 to enable
I2C and disable SPI
mode.

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

Size A4 | Number 1 | Revision 1

Date: 6/30/2022 | Sheet of 7 | 8
File: C:\Users\..\IMU-Section.SchDoc | Drawn By: | Huzaifa Ali

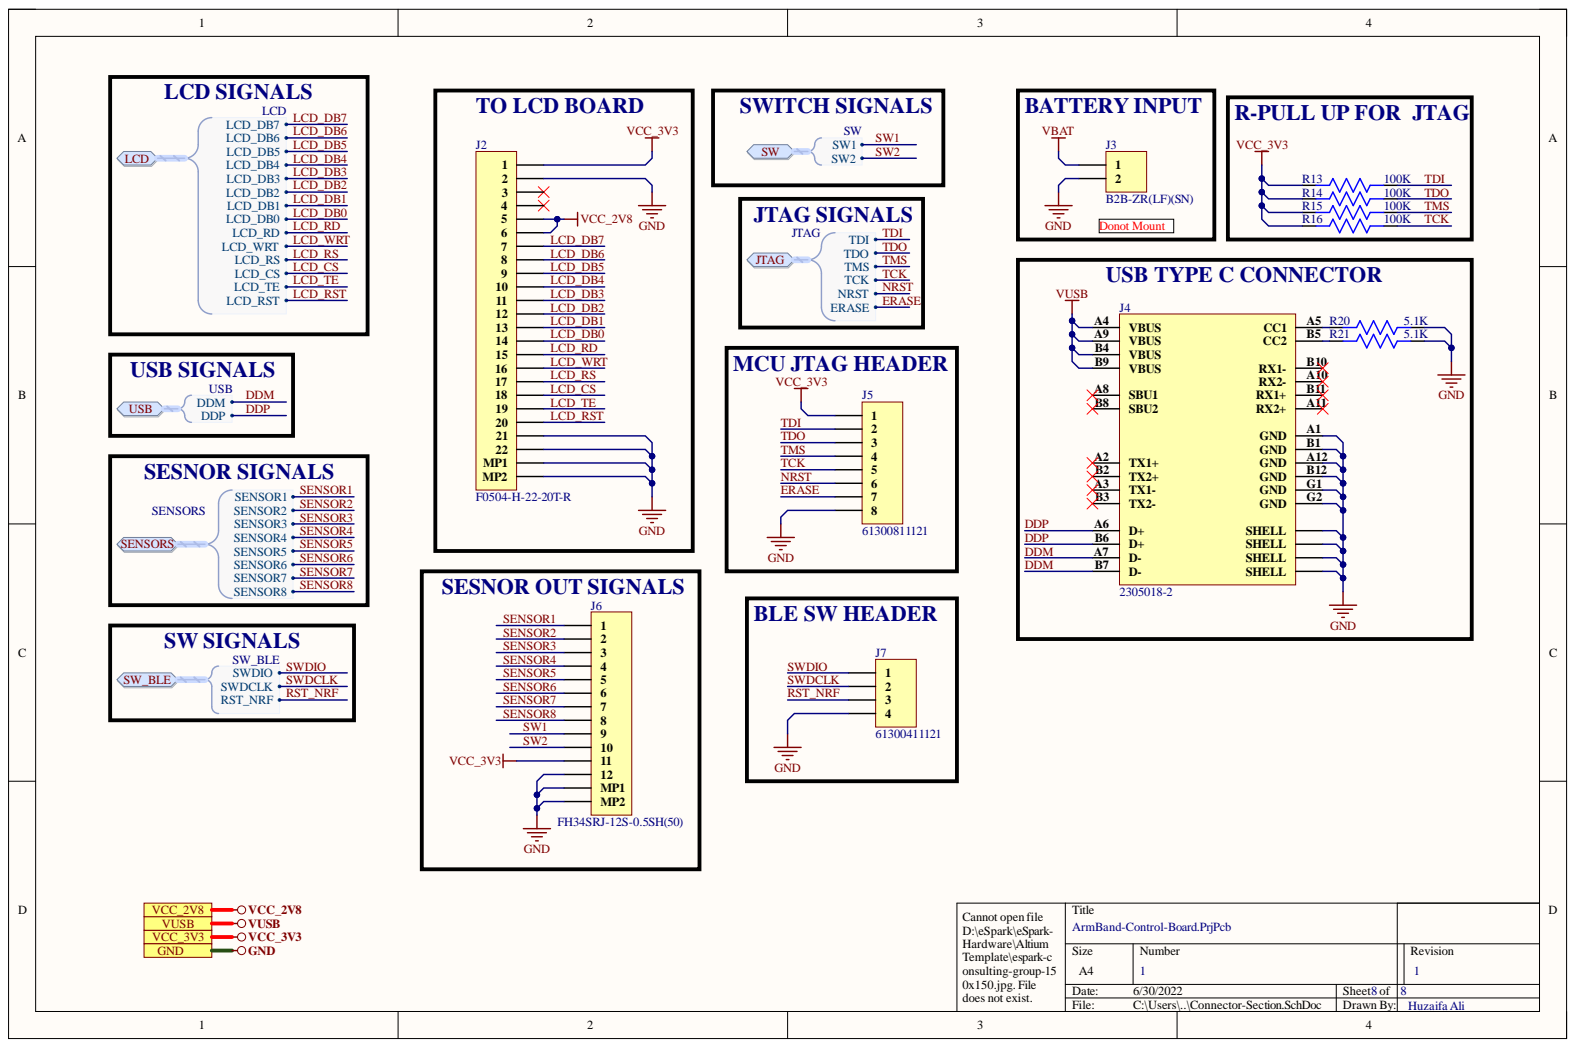
[picture p26: page 8]

R-PULL UP FOR JTAG LCD_DB7

Da te : 6/30/202 2 | She et of 8 | 8
File : C:\Use rs\. .\Conne ctor -S e c ti o n . S c hD o c | Dr awn B y | : Huz aifa A li
