eSpark-Backup/manar-harake-s-e-m-g-device/Deliverables/ArmBand-Electrode-Board/_Schematics/Electrode_Board.pdf

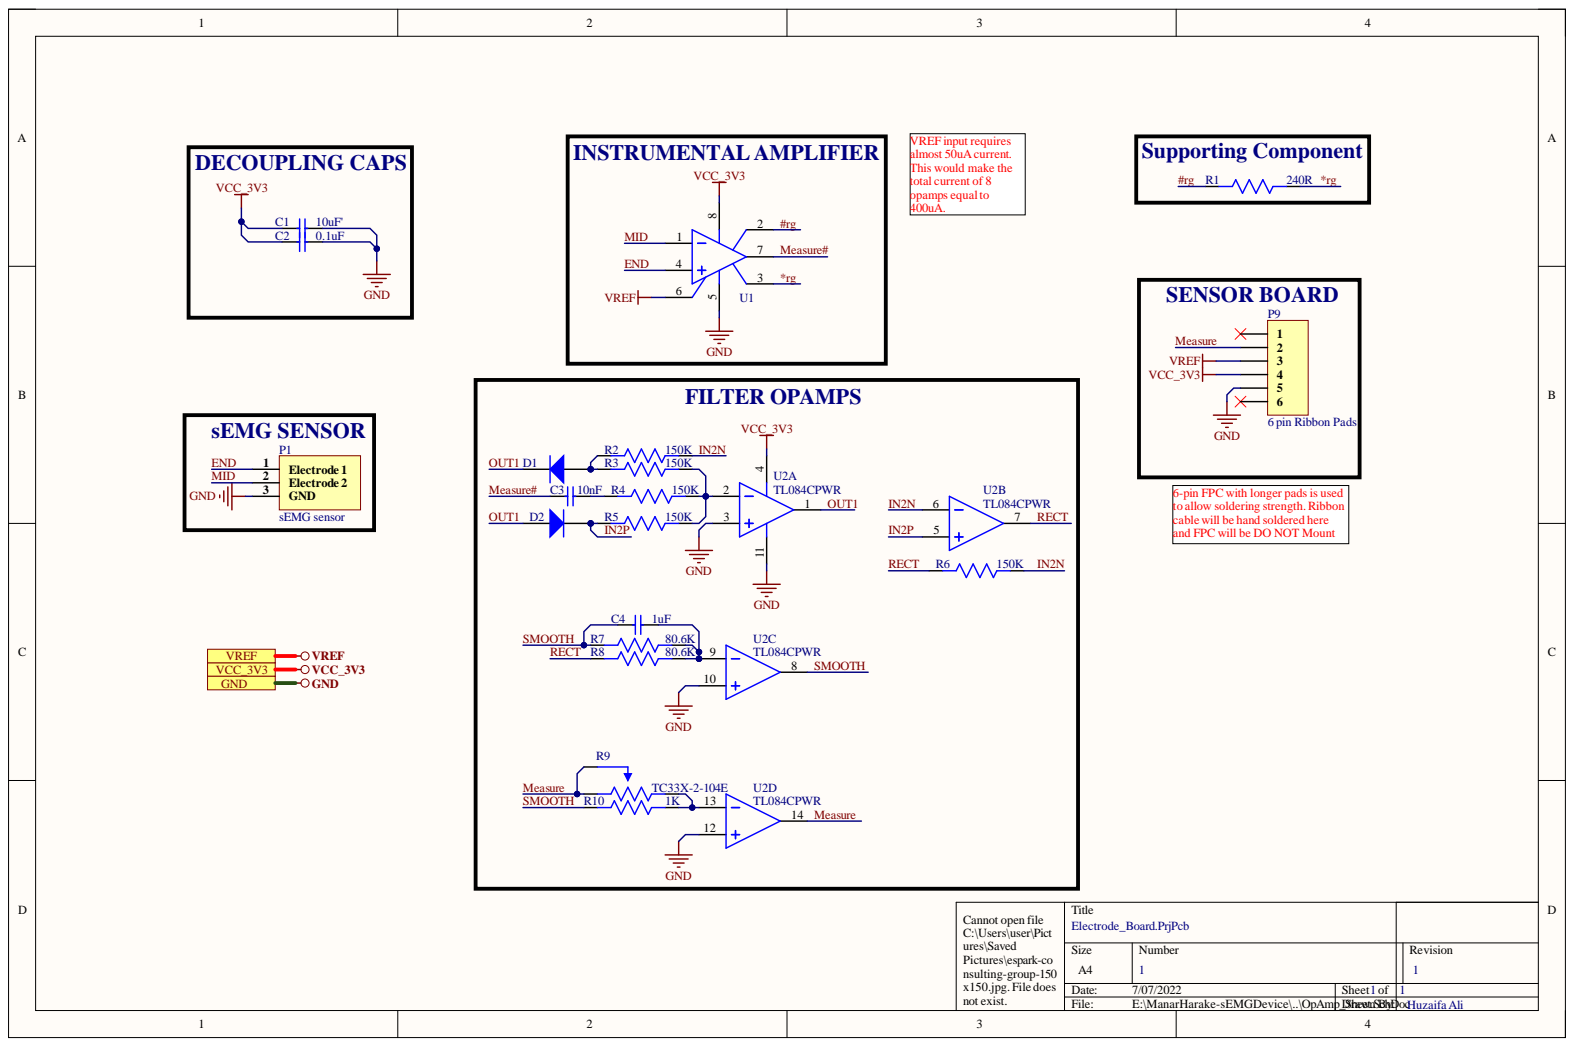
[picture p27: page 1]

almost 50uA current.
This would make the
total current of 8
opamps equal to

to allow soldering strength.Ribbon
cable will be hand soldered here
and FPC will be DO NOT Mount

Cannot open file C:\Users\user\Pict ures\Saved Pictures\espark-co nsulting-group-150 x150.jpg. File does not exist. | Title Electrode_Board.PrjPcb

Size A4 | Number 1 | Revision 1

Date: 7/07/2022 | Sheet of 1 | 1
File: E:\ManarHarake-sEMGDevice\..\OpAmp_DrShaewn et.SBchyD: | | oc Huzaifa Ali

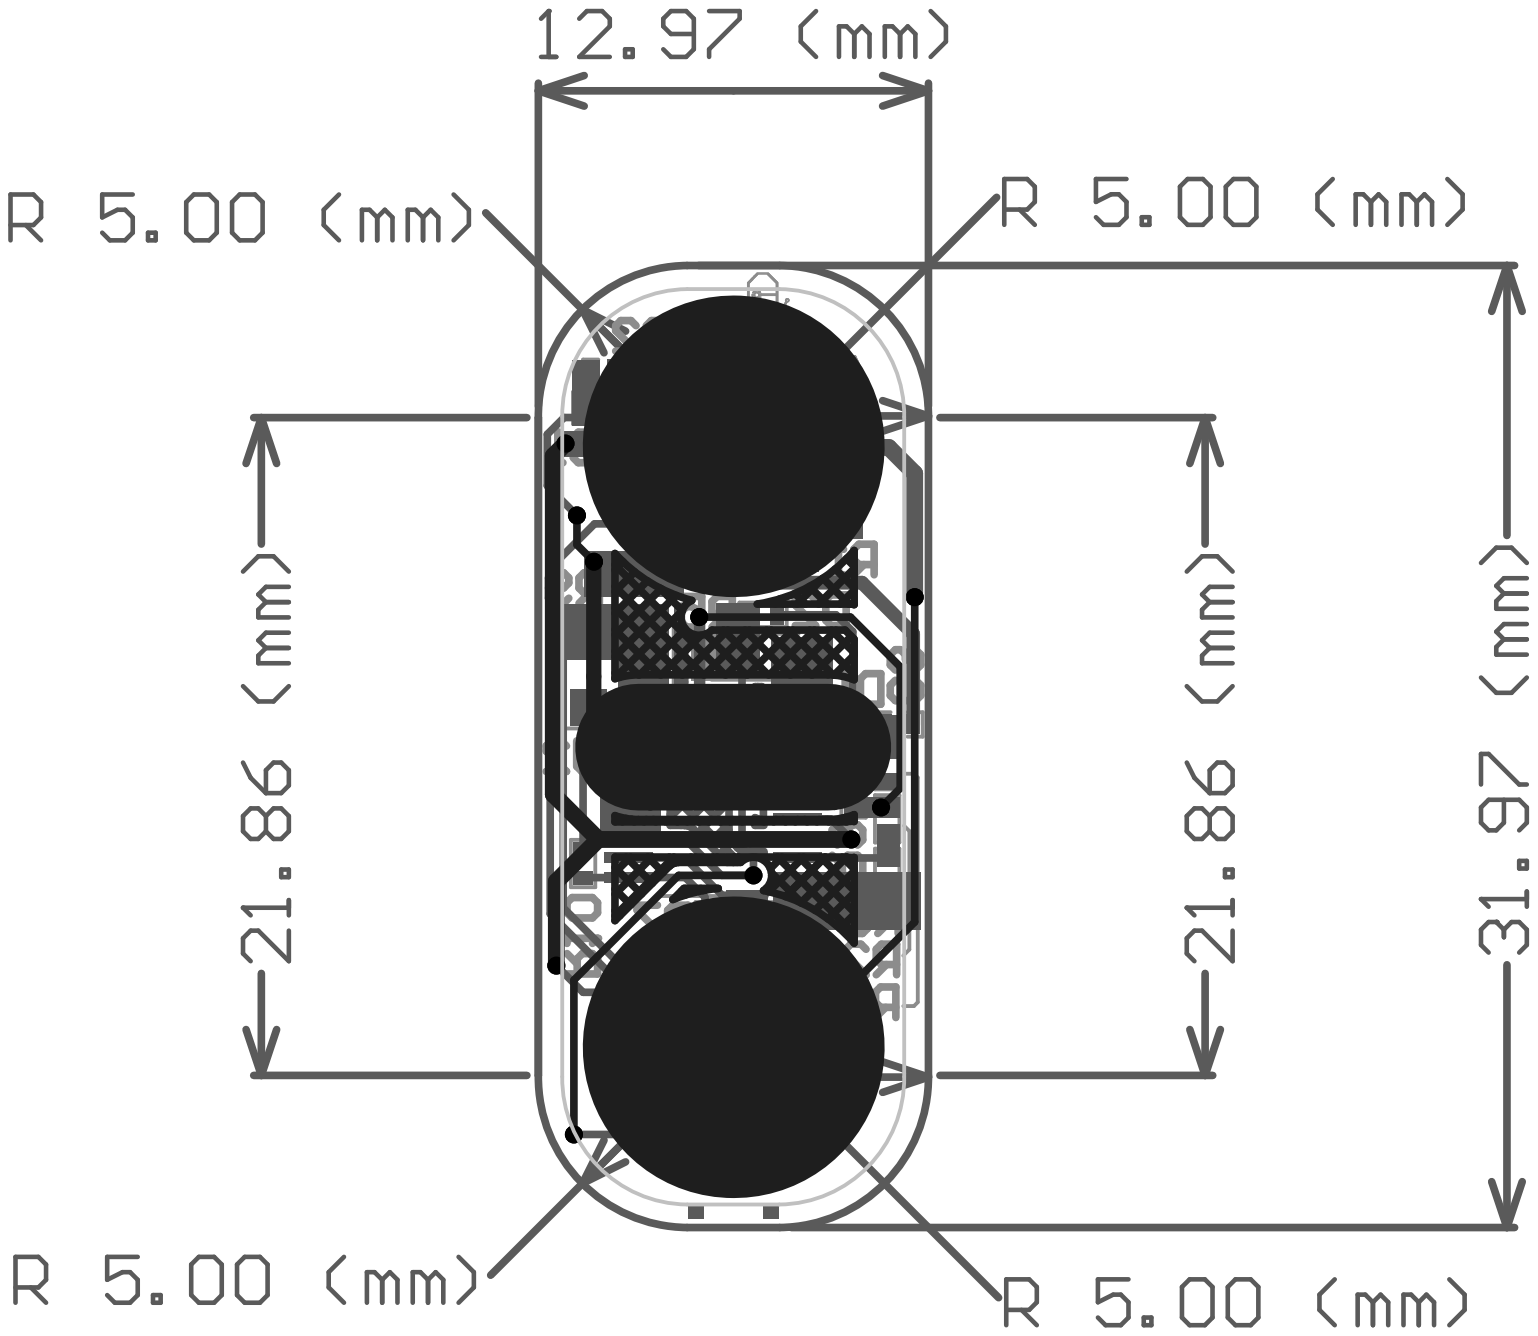
[picture p28: page 2]
