eSpark-Backup/manar-harake-s-e-m-g-device/Deliverables/ArmBand-Sensor-Board/_Schematics/ArmBand-Sensor-Board.pdf

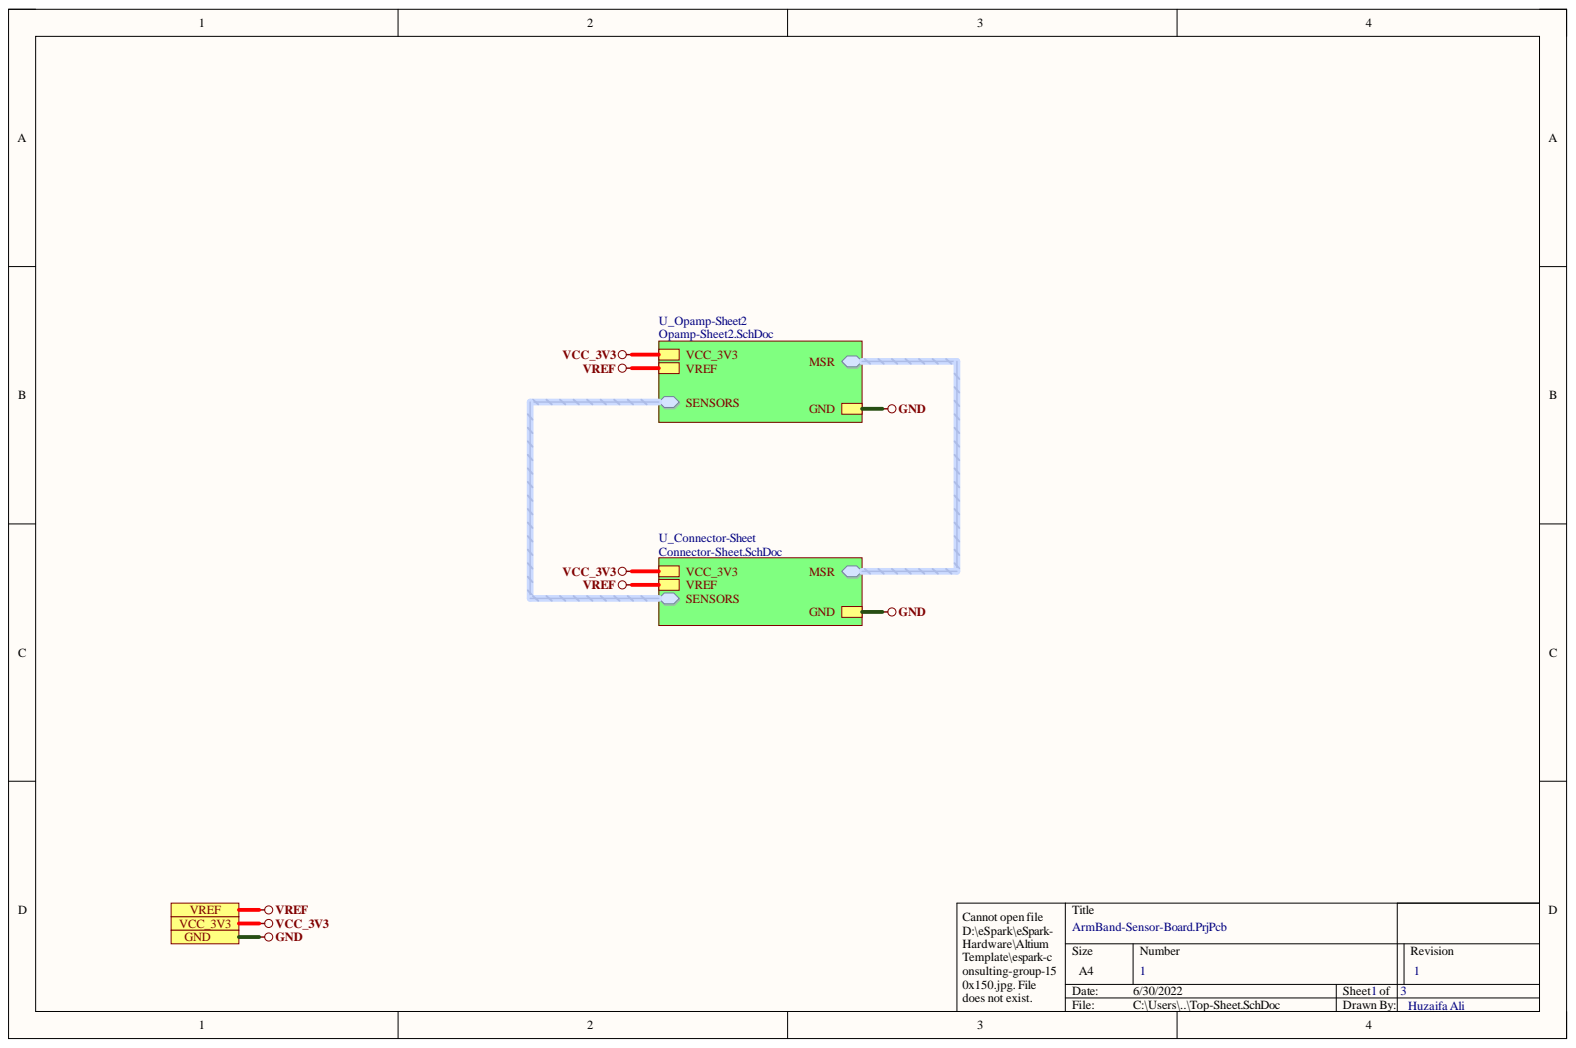
[picture p29: page 1]

Cannot open file D:\eSpark\eSpark-Hardware\Altium Template\espark-c onsulting-group-15 0x150.jpg. File does not exist. | Title ArmBand-Sensor-Board.PrjPcb

Size A4 | Number 1 | Revision 1

Date: 6/30/2022 | Sheet of 1 | 3
File: C:\Users\..\Top-Sheet.SchDoc | Drawn By: | Huzaifa Ali

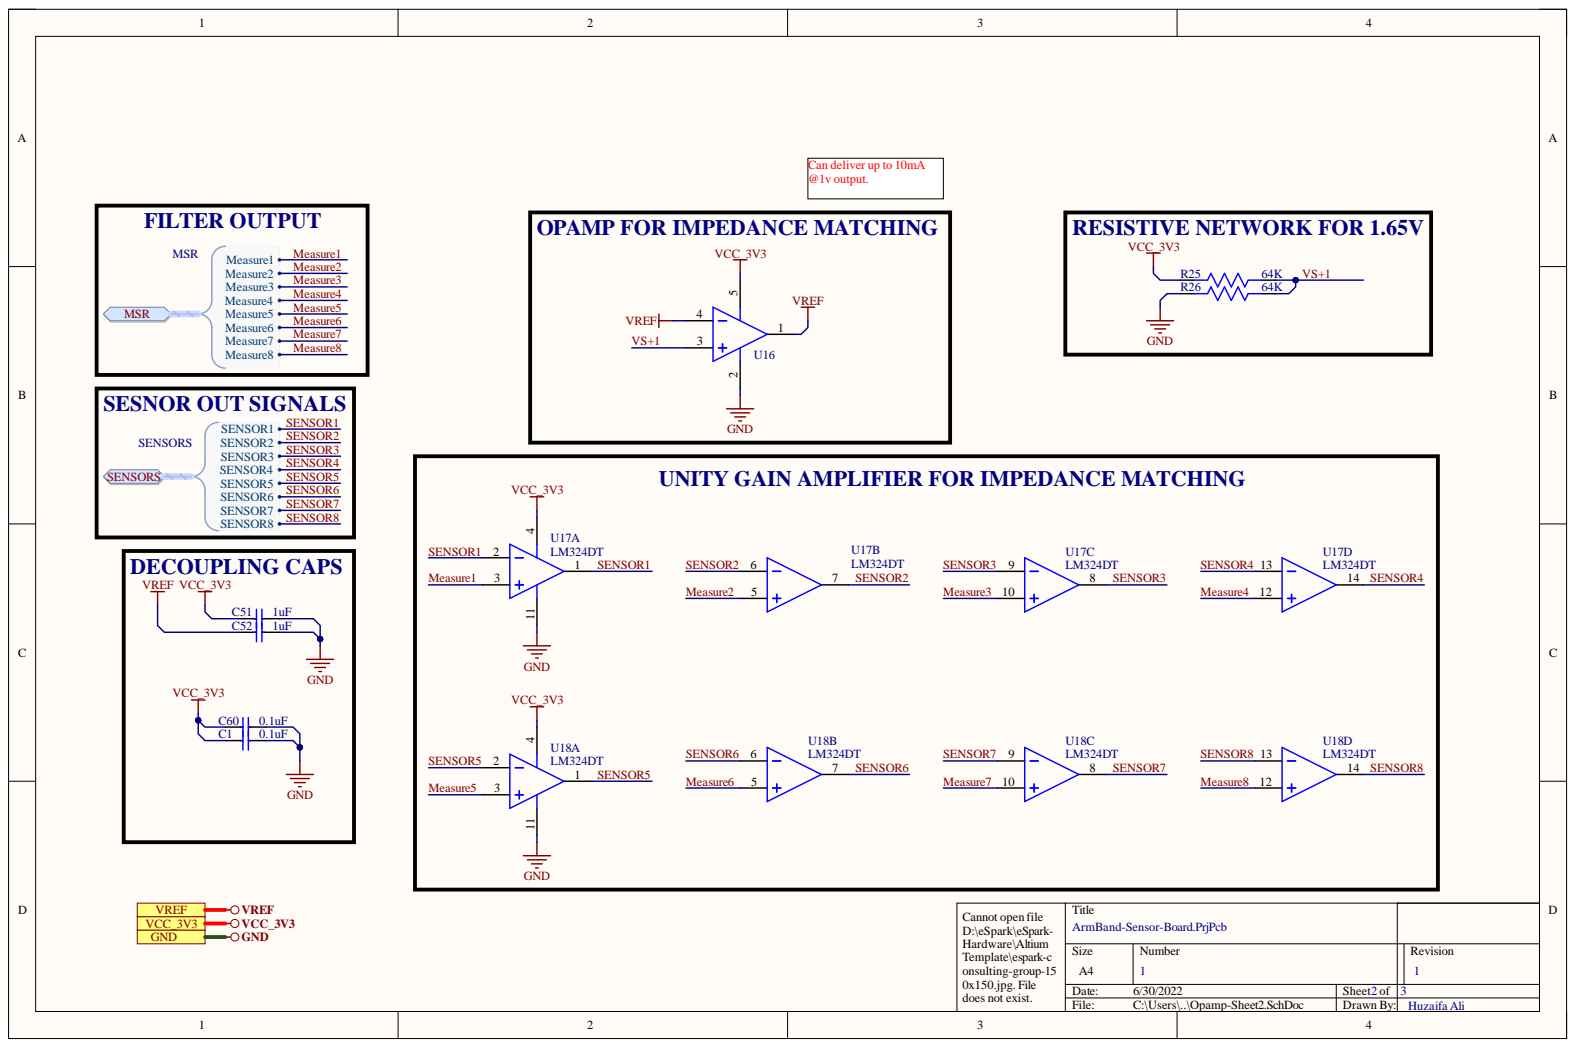
[picture p30: page 2]

UNITY GAIN AMPLIFIER FOR IMPEDANCE MATCHING

Siz e A4 | Numb e r 1 | R evisio n 1

Da te : 6/30/202 2 | She et of 2 | 3
File : C:\Use rs\. .\Opamp-She e t2 . S c hD o c | Dr awn B y | : Huz aifa A li

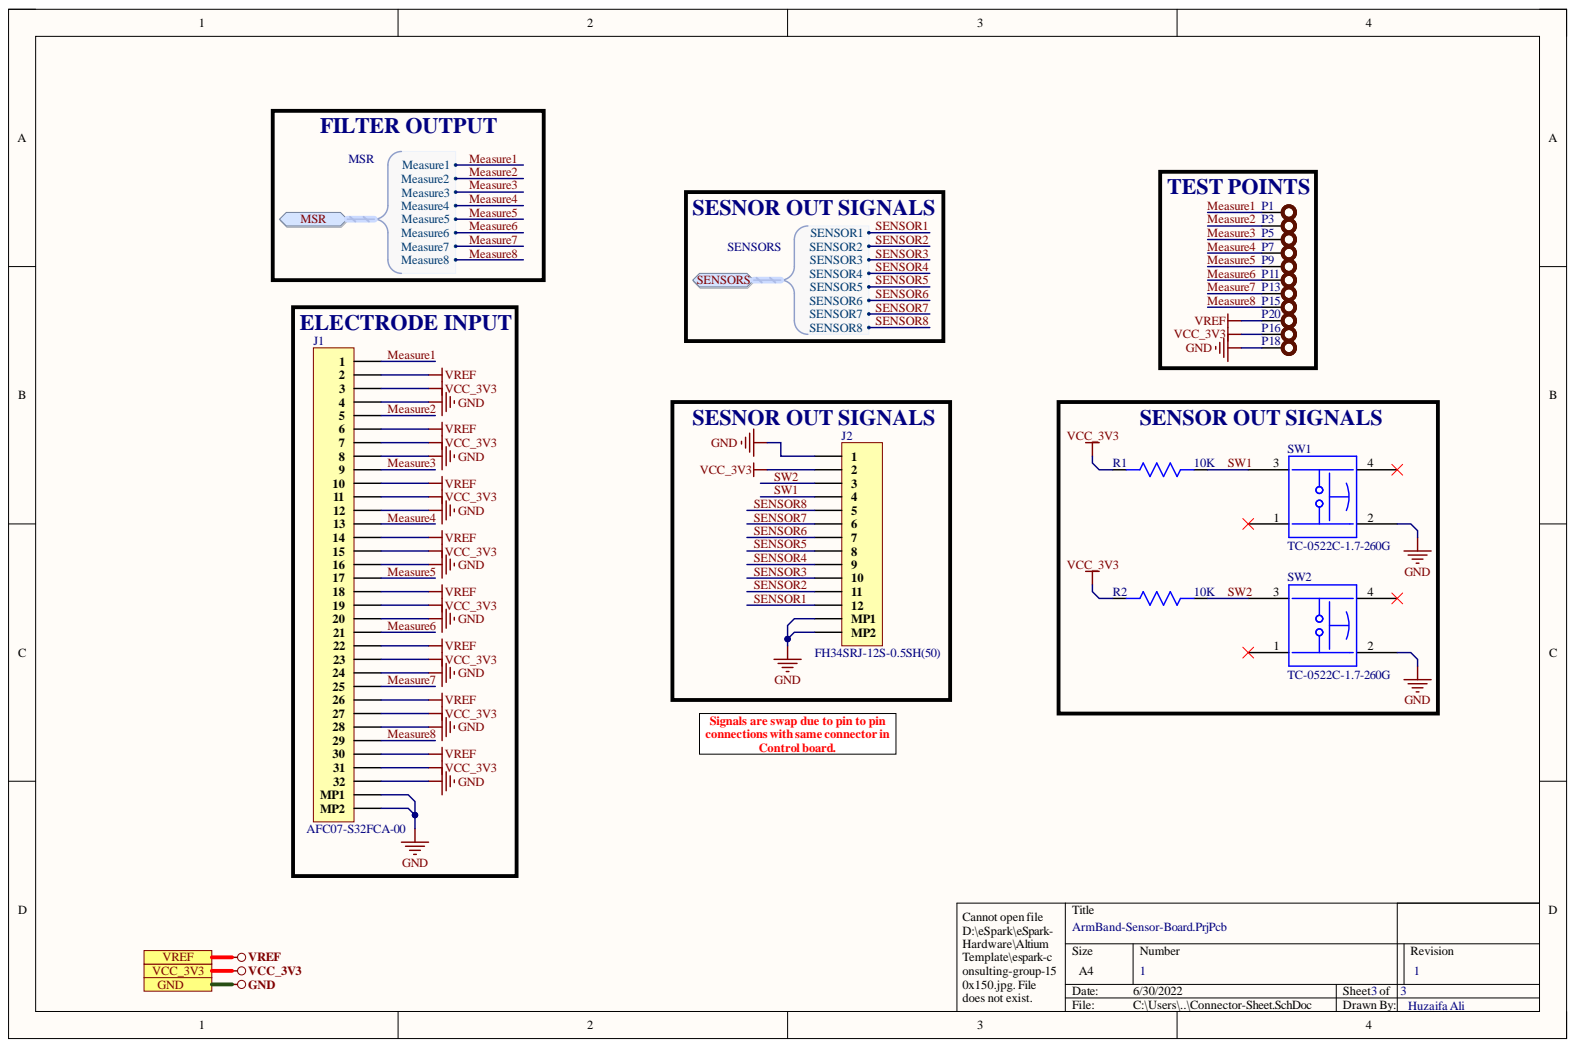
[picture p31: page 3]

C annot open file D:\e Spa rk\e S p ark-Hardware\Altium Template\espark-c onsulting-grou p -1 5 0x150.jpg. Fil e does not exist. | Titl e ArmB and-S ensor -B o ard . P rj P c b

Siz e A4 | Numb e r 1 | R evisio n 1

Da te : 6/30/202 2 | She et of 3 | 3
File : C:\Use rs\. .\Conne ctor -S he e t . S c hD o c | Dr awn B y | : Huz aifa A li
