eSpark-Backup/manar-harake-s-e-m-g-device/Deliverables/ArmBand-Sensor-Board/_Schematics/Assembly Drawings - ArmBand-Sensor-Board.pdf

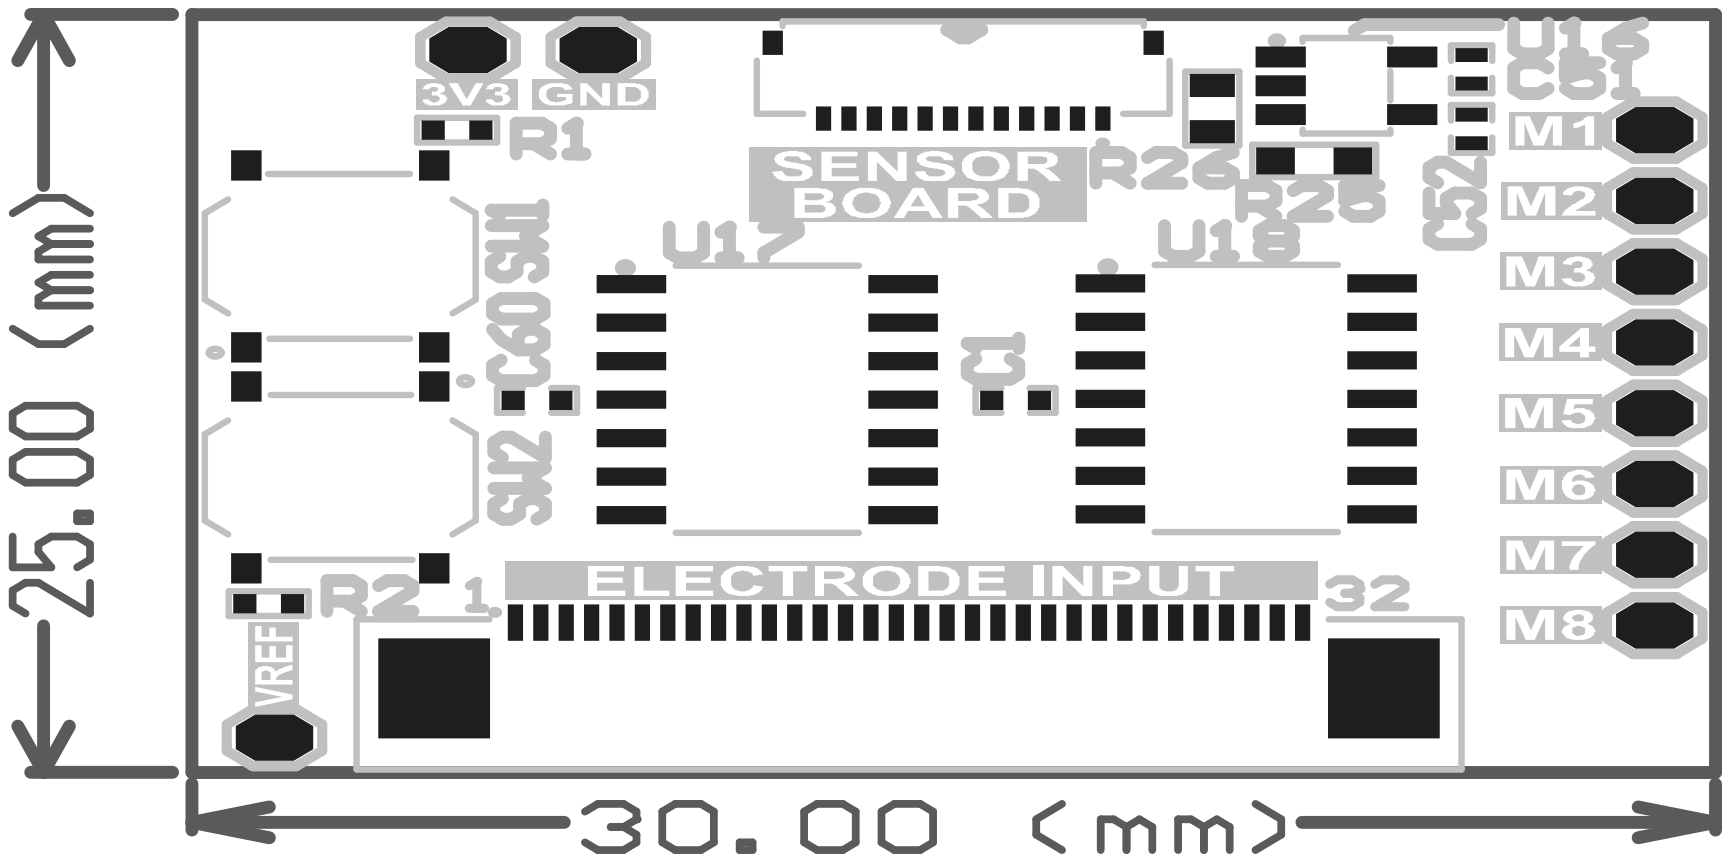
[picture p32: page 1]

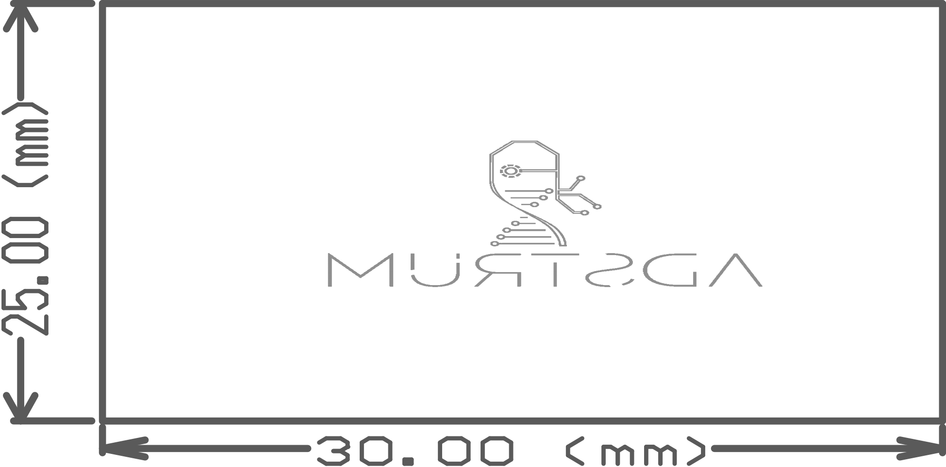
[picture p33: figure]
