eSpark-Backup/manar-harake-s-e-m-g-device/Deliverables/Control-Board-Flexible-PCB/_Schematics/Control_Board_Flex_Cable.pdf

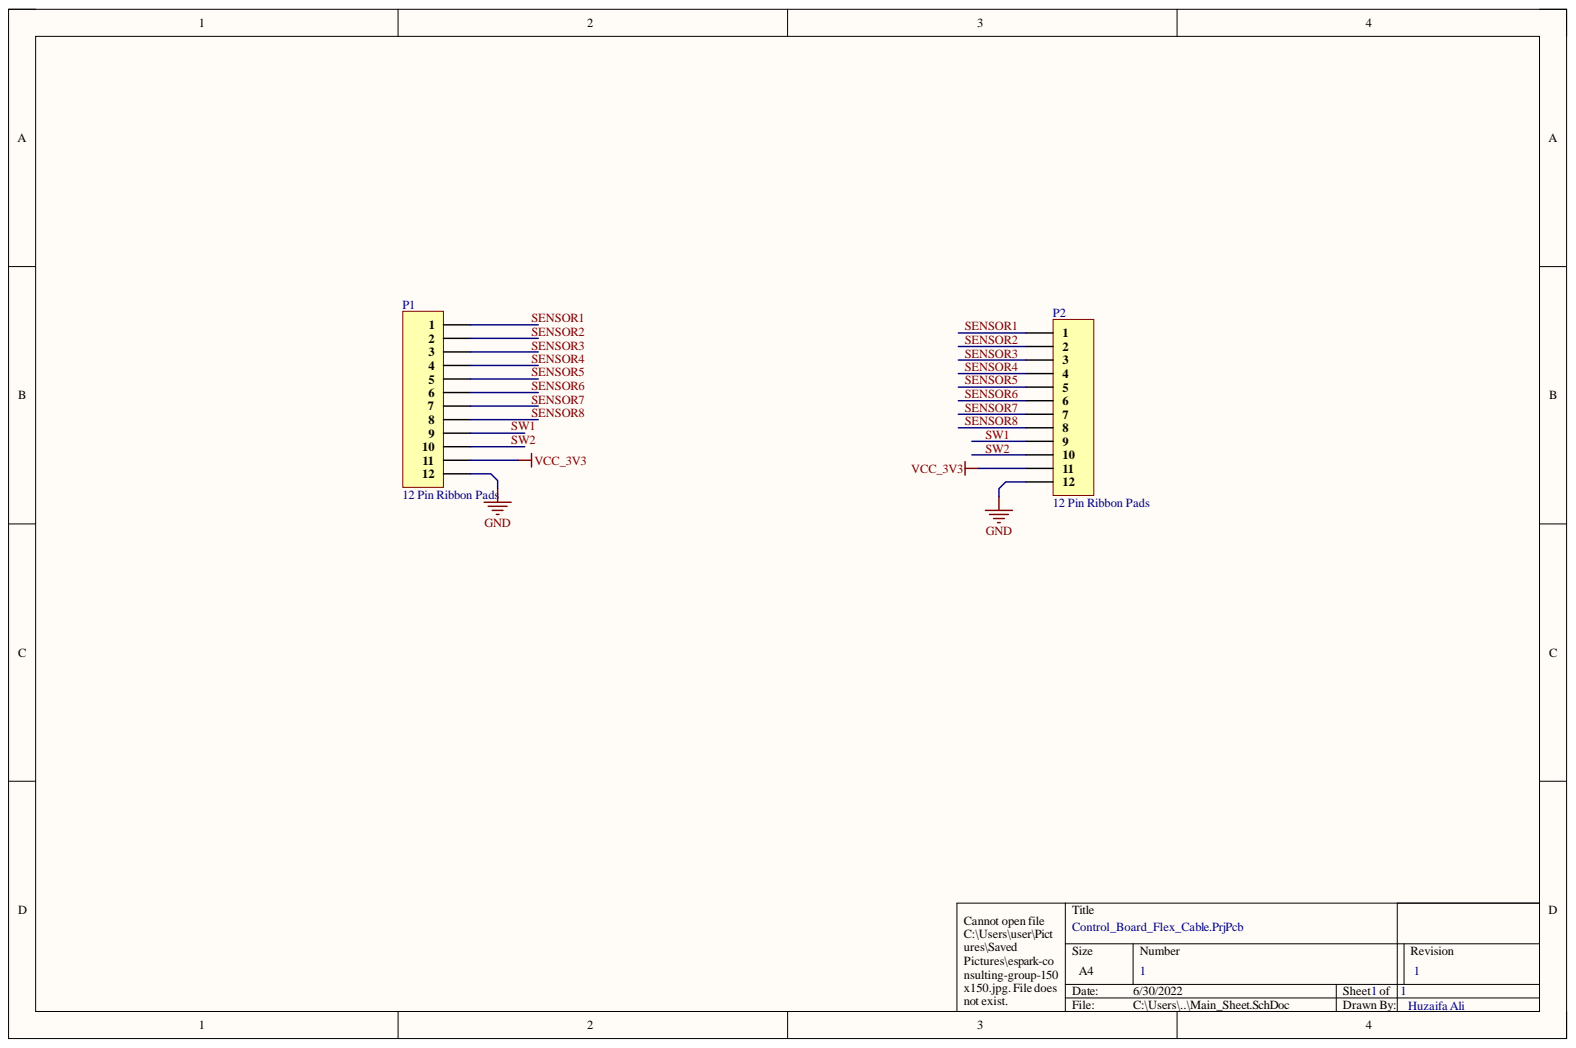
[picture p34: page 1]

C annot open file C:\Use rs\use r \P i c t ur es\S a v ed Pictur es\e s p ark-c o nsulting-group -1 5 0 x150.jpg. File does not exist. | Titl e Control_Boa rd_Flex_C a b le . P rj P c b

Siz e A4 | Numb e r 1 | R evisio n 1

Da te : 6/30/202 2 | She et of 1 | 1
File : C:\Use rs\. .\Main_She e t . S c hD o c | Dr awn B y | : Huz aifa A li
