eSpark-Backup/manar-harake-s-e-m-g-device/(list of files, drawings)

Other design files:
Design-Files/ArmBand-Control-Board/ArmBand-Control-Board.PrjPcb
Design-Files/ArmBand-Control-Board/Top-Sheet.SchDoc
Design-Files/ArmBand-Electrode-Board/Electrode_PCB.PcbDoc
Design-Files/ArmBand-LCD-Board (Archived)/LCD-Connector.SchDoc
Design-Files/ArmBand-Sensor-Board/Connector-Sheet.SchDoc
Design-Files/ArmBand-Sensor-Board/Top-Sheet.SchDoc
Design-Files/Octopus_Ribbon_PCB/Oct_Ribbon_V2.1_PCB.PcbDoc
Library-Files/sEMG.PcbLib
Library-Files/sEMG.SchLib
