eSpark-Backup/manar-harake-s-e-m-g-device/(commit log)

2022-05-20 Flow chart added in documents
2022-05-23 Schematic additions in progress
2022-05-24 Power section circuit in progress #4
2022-05-25 Power Section completed
2022-05-27 Schematic completion pending #4
2022-05-30 Schematic completed. Review and formatting pending #4
2022-05-31 Schematic Formatted and errors removed. LCD and ESD additions pending.
2022-05-31 #4 schematic additions complete
2022-06-01 sensor addition in progress #13
2022-06-03 #16 Completed. #17 connectors addition pending
2022-06-06 Connector added acc to #18
2022-06-06 Schematic completed #17. Components imported to PCB
2022-06-06 PCB Pars Placement Completed #21
2022-06-09 Adjustments for 2v8 regulator #21
2022-06-10 PCB Part Placement done #21 Routing remaining #25
2022-06-13 Routing of Control Board #25
2022-06-14 Routing of Control board #25 (paused due to some schematic changes after review)
2022-06-14 lib and schematic updated #39
2022-06-14 Control Board reviewed. Corrections in progress #39
2022-06-15 NRF circuitry changed #39
2022-06-15 Sensor board updated
2022-06-15 Power switch changed #39
2022-06-15 #41 Completed Control Board BOM
2022-06-16 #41 Completed (Sensor Board BOM)
2022-06-16 MIFA Antenna and some parts Placement #48
2022-06-16 PCB Parts placement and Routing some routes remaining
2022-06-17 Parts Placement of Sensor Board (not final)
2022-06-17 Routing of Control Board(incomplete)
2022-06-20 #49 (Quantity Per Board) Column name Updated.
2022-06-20 PCB Routing of Control board(Some routes remaining)
2022-06-21 PCB Routing of control Board #25
2022-06-21 Review of Control Board PCB done. See #63 for details.
2022-06-22 #56 schematic completed.
2022-06-22 Changes finished in Electrode Board #56
2022-06-22 Changes in Sensor Board done
2022-06-22 PCB Part Placement and Routing completed and thickness set to 1mm acc to #65
2022-06-22 Parts Placement and Routing of Sensor Board Completed
2022-06-22 Review done. Board outer dimension added. See #66 for details.
2022-06-22 PCB Parts Placement and Routing Done #65
2022-06-23 Filter Opamps added #56
2022-06-23 PCB Updated.
2022-06-23 U2 annotation corrected #56 PCB updated.
2022-06-23 Routing of PCB Acc #69
2022-06-23 Connector updated in Sensor board.
2022-06-24 MIFA ANTENNA added in Lib, Sch and PCB and Logo added in control and Electrode Board
2022-06-24 Logo set in Sensor Board
2022-06-25 Changes in Layer Stackup of Control Board.
2022-06-25 Layer Stackup of Sensor Board is updated.
2022-06-25 Layer Stackup of Electrode Board is updated.
2022-06-25 Placement corrected of J4 in control Board
2022-06-26 Sensor board project files corrected (incorrect files were merged)
2022-06-26 Electrode Board layer stackup corrected
2022-06-26 Sensor board layer stackup corrected
2022-06-26 Observing control board, no errors observed
2022-06-26 Octopus flex cable files (Manually merged)
2022-06-26 Overlay added for J6 of Control Board.
2022-06-26 Dot Indication added for J2 on Sensor Board as on Control Board.
2022-06-26 Schematic review #78
2022-06-27 #76 Octopus Cable Routing Completed.
2022-06-27 Corrections after review of NRF circuit #78
2022-06-27 Review of Electrode Board PCB done. See #86 for details.
2022-06-27 Routes corrected and logo added in Octopus Cable PCB. See #81 for details.
2022-06-27 Logo added in Control Board Flex Cable PCB.
2022-06-27 Control board reviewed #78
2022-06-27 Routing of Control Board (Incomplete). See #86 for details.
2022-06-28 Control board Client and eSpark board completed. #70
2022-06-28 Routing of control board completed
2022-06-28 Routing of Sensor Board completed
2022-06-28 #70 Control Board BOM Updated
2022-06-28 Review of Control Board done. Few routes changed. See #81 for details.
2022-06-28 Review of Sensor Board done. See #81 for details.
2022-06-28 Review of Electrode Board done. Logo added in new PCB of Octopus Ribbon Cable PCB. See #81 for details.
2022-06-29 Routing of Octopus Ribbon Cable PCB(Incomplete). See #81 for details.
2022-06-29 #81 Updated File (Sensor Board)
2022-06-29 Routing of Octopus cable and routing of sensor boards connect in senor board completed #83 #81
2022-06-29 Deliverables created for Control Board Flexible PCB. See #77 for details.
2022-06-29 Deliverables created for Octopus Ribbon Cable PCB. See #77 for details.
2022-06-29 Deliverables created for Electrode Board PCB. See #77 for details.
2022-06-29 Deliverables created for Control Board PCB. See #77 for details.
2022-06-29 Deliverables created for Sensor Board PCB. See #77 for details.
2022-07-01 Updated Files (Delete OLD Ribbon PCB File from Repo)
2022-07-01 Mounting Holes added and Fresh Deliverables created for Octopus Board. See #77 For Details.
2022-07-01 Fresh Deliverables created for Electrode Board. See #77 For Details.
2022-07-01 Fresh deliverables generated for Control Board Ribbon Flex Cable and Control Board. See #77 for details.
2022-07-01 Fresh deliverables generated for Sensor Board. See #77 for details.
2022-07-05 S.No 3 incorrect entry corrected in Control Board BOM
2022-07-05 Corrections in Electrode and Sensor board LCSC BOM
2022-07-05 Discontinued part number changed in LCSC Electrode BOM
2022-07-05 Part changed in LCSC Electrode Board BOM S.No 1
2022-07-06 DK set to 4.6 and Fresh Gerber and NC_Drill_Files generated for Control Boards
2022-07-06 Client shared sample CPL file
2022-07-06 CPL Files for all boards as per JLC Format #86
2022-07-07 PCB updated and Fresh deliverables generated for Electrode Board acc to #89
